javilxpez/TFG_Javi_lopez/memoria/capitulos/acronimos.tex

\chapter*{Acrónimos y símbolos}
\addcontentsline{toc}{chapter}{Acrónimos y símbolos}
\thispagestyle{plain}

\section*{Acrónimos}
\begin{longtable}{@{}L{0.18\textwidth}L{0.76\textwidth}@{}}
\toprule
\textbf{Sigla} & \textbf{Significado} \\
\midrule
\endhead
A/D, ADC & Convertidor analógico-digital (\emph{Analog-to-Digital Converter}) \\
API      & Interfaz de programación de aplicaciones \\
CDC      & Clase de dispositivo USB de comunicaciones (puerto serie virtual) \\
CRC      & Código de redundancia cíclica (\emph{Cyclic Redundancy Check}) \\
CSV      & Valores separados por comas (\emph{Comma-Separated Values}) \\
DE / RE  & Habilitación del emisor / receptor de un transceptor RS-485 \\
DI / DO  & Entrada digital / salida digital \\
EEPROM   & Memoria no volátil borrable eléctricamente \\
ESD      & Descarga electrostática (\emph{Electrostatic Discharge}) \\
FC       & Final de carrera \\
GPIO     & Entrada/salida de propósito general \\
GUI      & Interfaz gráfica de usuario \\
HTTP     & Protocolo de transferencia de hipertexto \\
I\textsuperscript{2}C & Bus serie síncrono de dos hilos (\emph{Inter-Integrated Circuit}) \\
LC       & Célula de carga (\emph{Load Cell}); LC1 y LC2 en el firmware \\
MISR     & Registro de firma de la EEPROM del ZSC31014 (\emph{Multiple-Input Signature Register}) \\
NC       & Contacto normalmente cerrado \\
ODS      & Objetivos de Desarrollo Sostenible \\
PCB      & Placa de circuito impreso (\emph{Printed Circuit Board}) \\
PIO      & E/S programable del RP2350 (\emph{Programmable I/O}) \\
POR      & Reinicio por encendido (\emph{Power-On Reset}) \\
RPM, rpm & Revoluciones por minuto \\
RS-485   & Estándar TIA/EIA-485 de transmisión diferencial multipunto \\
RTU      & Modo binario de Modbus sobre línea serie (\emph{Remote Terminal Unit}) \\
SMD      & Componente de montaje superficial \\
STO      & Desconexión segura del par (\emph{Safe Torque Off}) \\
TFG      & Trabajo Fin de Grado \\
UART     & Transmisor-receptor asíncrono universal \\
USB      & Bus serie universal \\
VRD      & Tambor de radio variable (\emph{Variable Radius Drum}) \\
WS       & WebSocket \\
\bottomrule
\end{longtable}

\section*{Símbolos principales}
\begin{longtable}{@{}L{0.17\textwidth}L{0.55\textwidth}L{0.16\textwidth}@{}}
\toprule
\textbf{Símbolo} & \textbf{Descripción} & \textbf{Unidad} \\
\midrule
\endhead
O         & Articulación de la barra & -- \\
C         & Eje de giro del tambor, en $(-x_t,\,L_2)$ & -- \\
T         & Punto de tangencia: por donde el cable abandona el tambor & -- \\
A$'$      & Punto de la barra donde tira el cable, $e_1$ sobre su eje & -- \\
P$'$      & Punto del que cuelga la masa, $e_2$ bajo el eje de la barra & -- \\
$L_2$     & Altura del eje del tambor sobre la articulación O & mm \\
$x_t$     & Eje del tambor a la izquierda de la vertical de O & mm \\
$|OC|$    & Distancia de O a C, $\sqrt{L_2^2+x_t^2}$ & mm \\
$L_3$     & De O al punto de tiro, medido sobre el eje de la barra & mm \\
$e_1$     & El cable tira $e_1$ por encima del eje de la barra & mm \\
$L_4$     & Del punto de tiro al de suspensión de la masa & mm \\
$e_2$     & La masa cuelga $e_2$ por debajo del eje de la barra & mm \\
$m$       & Masa suspendida & kg \\
$g$       & Aceleración de la gravedad & \si{\metre\per\second\squared} \\
$\theta$  & Ángulo de la barra respecto a la horizontal & ° \\
$\theta_0$& Valor de $\theta$ en B, donde arranca el ensayo & ° \\
$\theta_{\text{muerto}}$ & Punto muerto: la línea del cable pasa por O & ° \\
$\theta_{\text{libre}}$  & Reposo de la barra sin cable & ° \\
$\alpha$  & Ángulo en O entre la línea O$\to$C y la barra & ° \\
$c$       & Longitud libre de cable, de T a A$'$ & mm \\
$g_{\text{eq}}$ & Cable equivalente, $c-\operatorname{lado}\cdot r\,a_T$ & mm \\
$T$       & Tensión del cable & N \\
$\varphi$ & Giro del tambor contado desde B & rad \\
$\psi$    & Parámetro que recorre el perfil del tambor & rad \\
$r(\psi)$ & Radio del perfil del tambor & mm \\
$p$       & Brazo del cable en el eje del tambor, $p\le r$ & mm \\
$b_c$, $b_p$ & Brazos del cable y del peso respecto de O & mm \\
$r_0$, $r_1$ & Radios de la caracola al principio y al final del barrido & mm \\
$\tau$    & Par en el eje del tambor & N·m \\
$N$       & Reducción motor:tambor (vueltas de motor por vuelta de tambor) & -- \\
$p$       & Avance del eje del motor contado desde B & rev \\
$\tau_g$, $\tau_f$ & Componentes gravitatoria y de pérdidas del par medido & \ua \\
$r_{\text{ef}}$ & Radio efectivo estimado, $\propto \tau_g/T$ & \ua/N \\
\ua       & Unidades internas del accionamiento (registro 16387) & -- \\
\bottomrule
\end{longtable}
