javilxpez/TFG_Javi_lopez/memoria/capitulos/estadoarte.tex

\chapter{Estado del arte}
\label{chap:estado}

Este capítulo sitúa el trabajo frente a lo publicado sobre tambores de radio variable y mecanismos
de compensación, y frente a las plataformas con las que se ensayan.

\section{Antecedentes: variar el radio para repartir el par}

La idea de hacer variable el radio con que trabaja un cable, para que el par no siga ciegamente a la
fuerza, tiene un antecedente conocido en relojería. En los relojes de muelle el par disminuye a
medida que el muelle se desenrolla, y el \emph{fusee} lo corrige con un cono de perfil curvo y una
ranura helicoidal por la que trepa una cadena: con el muelle tenso la cadena tira del radio pequeño
y, al debilitarse, pasa al radio grande \cite{landes1983}. Lloyd \cite{lloyd1951} sitúa su origen en
el siglo XV, y Weaver \cite{weaver1980} fue quien, casi cinco siglos después, planteó por primera vez
la ecuación diferencial de su perfil.

Conviene ser preciso con el alcance de ese parecido, porque es más superficial de lo que sugiere la
analogía. El mecanismo de este trabajo \textbf{no es un fusee} ni lo imita. Un fusee es un cuerpo de
revolución cónico en el que el radio cambia \emph{axialmente}, a medida que la cadena avanza por la
hélice; aquí el tambor es una leva plana y el cable trabaja siempre en el mismo plano, con el radio
cambiando con el ángulo girado. Y, sobre todo, el problema físico es distinto: el fusee compensa una
fuerza que \emph{decae} de forma monótona, mientras que en este banco la tensión del cable no decae
---el capítulo~\ref{chap:modelo} muestra que crece---, de modo que ni el sentido de la corrección ni
la ley del perfil se trasladan. Lo único que comparten es el principio general de modular el brazo.

La familia a la que este mecanismo sí pertenece es la de los tambores de radio variable
(\emph{Variable Radius Drums}, VRD) y las poleas no circulares, formalizada en robótica.

Seriani y Gallina \cite{seriani2016} plantean la síntesis del
perfil de un tambor para que la carga siga una ley prescrita y obtienen soluciones analíticas
cerradas para varios casos. En los robots paralelos accionados por cables, Bieber \emph{et al.}
\cite{bieber2023} diseñan el perfil a partir del perfil de carga máxima del espacio de trabajo, de
modo que el par del motor no supere un valor dado para ninguna longitud de cable. Arsenault
\cite{arsenault2018} aborda el problema desde la fabricación y la cinemática del enrollado, y
establece las condiciones de \emph{convexidad} que debe cumplir el perfil para que el cable se
apoye sobre él sin despegarse ---una restricción que, como se verá, es la que acota la excentricidad
admisible en el tambor de este trabajo---. Ludovico \emph{et al.} \cite{ludovico2021} formulan la
síntesis del perfil como un problema de optimización convexa, con lo que la obtención del perfil
deja de depender de un buen punto de partida. La fabricación aditiva ha abaratado mucho estas
piezas, lo que explica el interés reciente.

\section{Compensación de gravedad con poleas no circulares}

Un segundo campo de aplicación es la compensación estática de peso. Herder \cite{herder2001} estudia
de forma sistemática los mecanismos estáticamente equilibrados, en los que la energía potencial
total se mantiene constante y el actuador sólo vence las pérdidas. Endo \emph{et al.}
\cite{endo2010} proponen una polea no circular combinada con un muelle para compensar el par
gravitatorio de un brazo, y deducen numéricamente la forma de la polea. Shen y Yano \cite{shen2022}
refinan ese cálculo teniendo en cuenta la variación de la tensión del cable a lo largo del
recorrido, y mejoran así la calidad de la compensación.

El mecanismo de este trabajo comparte el principio, con una diferencia importante: aquí no hay
muelle que almacene energía, sino un motor que aporta todo el trabajo de elevación. El tambor no
ahorra energía, sino que reparte el par.

\section{Lo que el cable impone al perfil}
\label{sec:arte-convexidad}

La literatura anterior sintetiza perfiles \emph{libres}: dada una ley de par, se obtiene la curva
$r(\varphi)$ que la produce, y se fabrica. El planteamiento es general, pero arrastra dos
restricciones que no siempre se hacen explícitas y que en este trabajo resultan decisivas.

La primera es de tolerancias. Johnston \emph{et al.} \cite{johnston2023} analizan la sensibilidad de
los mecanismos de leva enrollada a la incertidumbre en los parámetros y muestran que la ventaja
teórica de un perfil optimizado se degrada con los errores de fabricación y montaje. Gao \emph{et
al.} \cite{gao2018} resuelven el mismo problema inverso ---del par deseado al perfil--- en
mecanismos leva-muelle, y Litvin \emph{et al.} \cite{litvin2008} tratan la generación de funciones
de transmisión variables en engranajes no circulares.

La segunda es más fundamental, y es la que marca el límite de lo que se puede pedir a un tambor
accionado por cable: \textbf{un cable tenso sólo se asienta sobre un perfil convexo y de pendiente
suave}. En un tramo cóncavo, o en uno cuyo radio varíe demasiado rápido, el cable puentea el perfil
como una cuerda y el brazo que trabaja deja de ser el del perfil. Arsenault \cite{arsenault2018}
establece precisamente las condiciones de convexidad que debe cumplir un tambor de radio variable
para que el cable se apoye sobre él sin despegarse; en la práctica se traduce en mantener el ángulo
de presión $\arctan(|r'|/r)$ por debajo de unos \SI{25}{\degree}.

Esta condición es la que, en el capítulo~\ref{chap:modelo}, acaba descartando el perfil de par
exactamente constante para este banco: los perfiles que resuelven $r = \tau_0/T$ con un radio de
arranque alto exigen al cable pendientes de \SIrange{60}{80}{\degree}, que no puede seguir. La
aportación de este trabajo en ese punto no es un perfil nuevo, sino una cuantificación: sobre un
mecanismo real se muestra que, una vez impuesta la restricción del cable y comparando a igual
recorrido, la diferencia de par de pico entre todos los perfiles admisibles cae por debajo del
rozamiento del propio banco.

\section{Transmisiones por cable: el \emph{capstan drive}}
\label{sec:arte-capstan}

La reducción entre el motor y el tambor se resuelve en este trabajo con una transmisión por cable.
Su fundamento es la ecuación del cabrestante, que relaciona exponencialmente las tensiones a ambos
lados de un arrollamiento con el ángulo abrazado; Levin \cite{levin1991} la contrasta
experimentalmente, y Jung \emph{et al.} \cite{jung2008} la extienden para incluir la rigidez a
flexión de la cuerda y un rozamiento no lineal, efectos que la formulación clásica ignora y que
importan cuando el radio del cabrestante es pequeño.

Sobre ese principio, Werkmeister y Slocum \cite{werkmeister2007} caracterizan teórica y
experimentalmente la rigidez de un \emph{capstan drive}, y Baser y Konukseven \cite{baser2010} hacen
lo propio con su error de deslizamiento, las dos magnitudes que deciden si la transmisión sirve para
posicionar. En robótica, Mazumdar \emph{et al.} \cite{mazumdar2017} demuestran que una transmisión
de este tipo con fibra sintética alcanza rendimientos en torno al \SI{95}{\percent} y un ancho de
banda en par muy superior al de un reductor de engranajes, lo que la hace idónea para control de par
---que es justamente el uso que aquí se le da a la lectura del accionamiento---. Hwangbo \emph{et
al.} \cite{hwangbo2018} la llevan a robots de alta dinámica.

La configuración concreta que sigue este trabajo está tomada de un proyecto abierto de Musa
\cite{musa2024}, que documenta una reducción de \num{8.55}:1 con cuerda de Dyneema y recorrido
limitado a \SI{120}{\degree}. Conviene señalar que se trata de literatura gris, sin revisión por
pares; se cita por la utilidad de sus detalles constructivos, apoyándose para las afirmaciones de
fondo en las referencias académicas anteriores.

Las ventajas que importan aquí son la holgura nula y la transparencia de par: cualquier holgura o
rozamiento del reductor contaminaría precisamente la señal que el banco quiere medir. Las
limitaciones ---recorrido acotado y necesidad de retensado--- son asumibles en un mecanismo que
trabaja entre dos finales de carrera.

\section{Cuerda sintética frente a cable de acero}
\label{sec:arte-dyneema}

La elección del material de la cuerda no es accesoria. El criterio determinante en una transmisión
de radio pequeño es la relación entre el diámetro del tambor y el del cable, $D/d$: por debajo de
cierto valor, el cable de acero falla por fatiga de flexión en muy pocos ciclos, y Feyrer
\cite{feyrer2007} recoge el tratamiento canónico de esa vida a fatiga. Las fibras de polietileno de
ultra alto peso molecular (UHMWPE, comercialmente Dyneema) toleran radios mucho menores, lo que
permite cabrestantes pequeños y, con ellos, reducciones altas en poco espacio. McKenna \emph{et al.}
\cite{mckenna2004} es la referencia general de mecánica de cuerda de fibra, y Davies \emph{et al.}
\cite{davies2015} proponen un modelo empírico de vida bajo flexión cíclica sobre polea que permite
dimensionar $D/d$ con criterio.

El punto débil de estas fibras es la fluencia: un alargamiento permanente bajo carga mantenida que
se traduce en pérdida de tensión y, por tanto, en error de posicionamiento. Vlasblom y Bosman
\cite{vlasblom2006} modelan la vida por fluencia y muestran su fuerte dependencia del grado de fibra
y de la temperatura. De ahí que una transmisión de este tipo necesite un tensor y un retensado
periódico, y que el modelo del capítulo~\ref{chap:modelo} advierta de que la hipótesis de cable
inextensible sólo vale entre retensados.

\section{Bancos de ensayo y validación experimental}

En los trabajos citados, la validación experimental suele consistir en medir el par o la corriente
del actuador a lo largo del recorrido y compararlos con el perfil previsto. Esa comparación exige
tres medidas sincronizadas: posición del eje, fuerza en el cable y par del actuador. Los equipos
comerciales de adquisición que resuelven esto tienen un coste muy superior al del propio prototipo,
y los accionamientos industriales modernos ya publican velocidad y par por bus de campo, de modo que
buena parte de la instrumentación puede sustituirse por software.

Ésa es la oportunidad que aprovecha este TFG: construir, con componentes comerciales de bajo coste y
herramientas libres, un banco que registre las tres magnitudes con la misma base de tiempos, guarde
los datos en bruto y permita contrastar el modelo del mecanismo con la medida. Un resultado
colateral del trabajo, que se detalla en el capítulo~\ref{chap:resultados}, es que esa
instrumentación completa resulta \emph{necesaria}: la medida de fuerza por sí sola no basta para
determinar el perfil del tambor, porque la calibración desconocida de la célula admite soluciones
con el signo invertido; es el par del accionamiento el que deshace la ambigüedad.

\section{Conclusiones del estado del arte}

Los tambores de radio variable están bien estudiados como principio y existen métodos de síntesis de
su perfil, igual que están bien caracterizadas las transmisiones por cable y las fibras sintéticas
que las hacen viables. De ese panorama se desprenden las dos líneas que sigue este trabajo.

La primera es de diseño: casi toda la literatura da por supuesto que afinar el perfil merece la
pena, y lo demuestra sobre el perfil de par. Aquí se compara a igual recorrido y midiendo lo que de
verdad dimensiona el accionamiento, que es el par de pico; el capítulo~\ref{chap:modelo} muestra que
en este mecanismo la diferencia entre todos los perfiles admisibles queda por debajo del rozamiento
del banco, de modo que la elección del perfil importa mucho menos de lo esperado.

La segunda es experimental: falta una plataforma asequible que permita medir en un prototipo real
cómo se reparte el par y contrastarlo con el modelo. Para ello hay que integrar un accionamiento
industrial por Modbus, un acondicionador de célula de carga con reglas de configuración estrictas y
una cadena de adquisición con marcas de tiempo fiables, que es lo que desarrollan los capítulos
siguientes. El capítulo~\ref{chap:resultados} muestra además por qué esa instrumentación tiene que
ser completa: la fuerza sola no determina la geometría.
