javilxpez/TFG_Javi_lopez/memoria/capitulos/modelo.tex

\chapter{Modelo del mecanismo}
\label{chap:modelo}

Este capítulo desarrolla el modelo estático del mecanismo: relaciona el giro del tambor con el
ángulo de la barra, la longitud del cable y su tensión, y de ahí obtiene el par. Las mismas
ecuaciones están implementadas en \fichero{static/mecanismo.js}, de modo que el simulador, el visor
de ensayos y las figuras de esta memoria calculan exactamente lo mismo; el
anexo~\ref{anx:repo} indica cómo regenerar las cifras.

Conviene avisar de entrada de que este modelo sustituye a uno anterior, y que la diferencia no es de
refinamiento sino de física. En la primera versión el cable salía de un punto fijo D, desplazado una
distancia $dx$ de la vertical de la articulación. Ese modelo no podía representar la barra colgando
por debajo de cierto ángulo, y el ajuste lo compensaba invirtiendo el sentido de la espiral, de donde
salían unas conclusiones que la sección~\ref{sec:mod-porque} explica y descarta. El cable no sale de
un punto: sale \emph{tangente} al tambor, y el punto de salida se mueve cuando el radio cambia.

\section{Descripción del mecanismo}

La figura~\ref{fig:mecanismo} muestra el esquema. Una barra rígida articulada en O gira en un plano
vertical. El tambor va montado sobre un carril a la izquierda de O, con su eje de giro en
\begin{equation}
  C = (-x_t,\; L_2),
\end{equation}
y el cable baja desde el tambor hasta la barra. Se usan dos convenios que conviene fijar porque
atraviesan todo el capítulo:

\begin{itemize}
  \item El ángulo de la barra, $\theta$, se mide \emph{desde la horizontal}. Es lo que se configura y
        lo que se puede comprobar con un inclinómetro apoyado en la barra, sin modelo de por medio.
        Internamente se usa también $\alpha = \mathrm{inc}_C - \theta$, el ángulo en O entre la línea
        O$\to$C y la barra, que es el que entra en la ley del coseno.
  \item La barra lleva dos desfases respecto de su propio eje: el cable no tira del eje sino de un
        punto A$'$ situado $e_1$ por encima, y la pesa no cuelga del eje sino de P$'$, $e_2$ por
        debajo. Con $\hat u = (\cos\theta, \operatorname{sen}\theta)$ la dirección de la barra y
        $\hat n$ su perpendicular,
        \begin{equation}
          A' = L_3\,\hat u + e_1\,\hat n, \qquad P' = (L_3+L_4)\,\hat u - e_2\,\hat n .
        \end{equation}
\end{itemize}

\begin{figure}[H]
\centering
\begin{tikzpicture}[scale=1.55,>=Stealth]
  \coordinate (O)  at (0,0);
  \coordinate (C)  at (-0.45,3.30);
  \coordinate (Ap) at (0.856,-0.458);
  \coordinate (Pp) at (1.442,-1.471);
  \coordinate (Tg) at (0.037,3.403);
  \coordinate (Aej) at (0.728,-0.611);
  % carril y suelo
  \draw[gray!45,line width=2pt] (-0.45,-1.0) -- (-0.45,3.75);
  \fill[gray!25] (-0.22,-0.12) rectangle (0.22,0);
  % tambor
  \draw[violet,thick,fill=violet!7] (C) circle (0.50);
  \fill[violet] (C) circle (1.1pt) node[left=3pt,font=\small] {C};
  \draw[violet,dashed] (C) -- (Tg);
  \node[violet,font=\small] at (-0.03,3.17) {$r$};
  \node[violet,font=\small,right] at (0.08,3.72) {tambor};
  % barra
  \draw[line width=2.2pt] (O) -- (Pp);
  \draw[dashed,gray] (O) -- (1.35,0);
  \draw[->] (0.60,0) arc (0:-40:0.60);
  \node[font=\small] at (0.80,-0.15) {$\theta$};
  % cable
  \draw[blue!70!black,thick] (Ap) -- (Tg) node[pos=0.42,right=1pt] {$c$};
  \draw[->,thick,red!75!black] (Ap) -- ($(Ap)!0.18!(Tg)$) node[right=2pt] {$T$};
  \fill (Tg) circle (1.0pt) node[above right=-2pt,font=\small] {T};
  % puntos de la barra
  \draw[blue!70!black,thin] (Aej) -- (Ap);
  \fill[blue!70!black] (Ap) circle (1.3pt) node[above right=-2pt,font=\small] {A$'$};
  \fill[gray] (Aej) circle (0.8pt);
  \node[font=\scriptsize,gray,right=1pt] at (0.84,-0.60) {$e_1$};
  \fill[orange!80!black] (Pp) circle (1.3pt) node[below right=-1pt,font=\small] {P$'$};
  \draw[->,thick] (Pp) -- ++(0,-0.42) node[right] {$mg$};
  % cotas
  \draw[<->] (-0.95,0) -- (-0.95,3.30) node[midway,left] {$L_2$};
  \draw[dotted] (-1.0,3.30) -- (-0.50,3.30);
  \draw[<->] (-0.45,-0.75) -- (0,-0.75) node[midway,below=-1pt,font=\small] {$x_t$};
  \fill (O) circle (1.5pt) node[above left=-1pt] {O};
  \node[font=\small] at (0.40,-0.52) {$L_3$};
  \node[font=\small] at (1.32,-0.86) {$L_4$};
\end{tikzpicture}
\caption{Esquema del mecanismo. El cable sale \emph{tangente} al tambor, en el punto T, y no de un
punto fijo: al cambiar el radio, la línea del cable se desplaza.}
\label{fig:mecanismo}
\end{figure}

El modelo parte de las siguientes hipótesis:
\begin{enumerate}[label=H\arabic*.]
  \item Régimen cuasiestático: a velocidad constante se desprecian las fuerzas de inercia.
  \item Cable inextensible y sin masa, que se mantiene tenso y se asienta sobre el perfil.
  \item Se desprecia la masa de la barra frente a la masa suspendida.
  \item Las pérdidas por rozamiento no entran en el modelo estático: se tratan aparte en la
        sección~\ref{sec:mod-separacion}.
\end{enumerate}

\section{Los dos ángulos límite del mecanismo}

Antes de las ecuaciones conviene fijar dos ángulos que no son parámetros de diseño sino propiedades
de la geometría, y que acotan el recorrido útil.

El \textbf{punto muerto} es el ángulo al que la línea del cable pasa por O. Ahí el brazo del cable se
anula mientras la pesa sigue haciendo momento, de modo que la tensión se iría a infinito y el
mecanismo no puede sostener la carga. Ocurre cuando A$'$ cae sobre la tangente trazada desde O al
tambor, que forma un ángulo $\gamma = \arcsin(r/|OC|)$ con la línea O$\to$C:
\begin{equation}
  \theta_{\text{muerto}} = \mathrm{inc}_C - \operatorname{lado}\cdot\gamma - \delta - 180^\circ,
  \qquad \delta = \arctan\frac{e_1}{L_3},
  \label{eq:muerto}
\end{equation}
donde $\operatorname{lado} = +1$ si el cable baja por la derecha del tambor. Con la geometría del
banco cae en \SI{-106.4}{\degree}.

El \textbf{reposo libre} es el ángulo al que queda la barra sin cable: la pesa se sitúa justo bajo el
pivote y su brazo se anula. Como el cable sólo puede tirar, nunca empujar, es el $\theta$ mínimo al
que la barra puede quedarse:
\begin{equation}
  \theta_{\text{libre}} = -\arctan\frac{L_3+L_4}{e_2},
  \label{eq:libre}
\end{equation}
que con $L_3+L_4 = \SI{205}{\milli\metre}$ y $e_2 = \SI{20}{\milli\metre}$ da
\SI{-84.4}{\degree}. Es una cota que se mide sin modelo —inclinómetro sobre la barra con el cable
flojo— y de ella sale $e_2$, que resulta ser el parámetro más sensible del banco. Explica además las
lecturas minúsculas y erráticas de la célula al principio del ensayo: ahí el mecanismo no necesita
fuerza.

\section{Tensión del cable}
\label{sec:mod-tension}

Con $|OC| = \sqrt{L_2^2 + x_t^2}$ y $L_3' = \sqrt{L_3^2+e_1^2}$, la ley del coseno en el triángulo
O--C--A$'$ da la distancia del eje del tambor al punto de tiro:
\begin{equation}
  d^2 = |OC|^2 + L_3'^2 - 2\,|OC|\,L_3'\cos\beta, \qquad \beta = \alpha - \delta .
  \label{eq:dca}
\end{equation}
Como el radio es perpendicular a la tangente, el cable libre es el cateto del triángulo rectángulo
C--T--A$'$:
\begin{equation}
  c = \sqrt{d^2 - r^2}.
  \label{eq:cable}
\end{equation}

El equilibrio de momentos en O enfrenta el brazo del cable, $b_c$ ---la distancia de O a la recta
T--A$'$---, con el brazo del peso, que por colgar la pesa por debajo del eje tiene dos términos:
\begin{equation}
  \boxed{\;T = \frac{m\,g\,b_p}{b_c}\;}\qquad
  b_p = (L_3+L_4)\cos\theta + e_2\operatorname{sen}\theta .
  \label{eq:tension}
\end{equation}
El segundo término de $b_p$ es el que hace que el brazo del peso se anule en
$\theta_{\text{libre}}$ en lugar de en \SI{-90}{\degree}.

\subsection{El cable equivalente}
\label{sec:mod-equivalente}

Aquí está el punto más delicado del modelo. Al moverse la barra, el punto de tangencia T
\emph{migra} por la superficie del tambor, y esa migración enrolla o desenrolla cable sin que el
tambor haya girado. Dicho de otro modo: el cable que el tambor paga al girar no es la variación del
cable libre $c$. Lo que se conserva es el \emph{cable equivalente}
\begin{equation}
  g = c - \operatorname{lado}\cdot r\,a_T ,
  \label{eq:equivalente}
\end{equation}
siendo $a_T$ el ángulo del punto de tangencia sobre el tambor. La comprobación es por trabajos
virtuales: $-\mathrm{d}g/\mathrm{d}\theta$ es exactamente el brazo del cable en O, mientras que
$-\mathrm{d}c/\mathrm{d}\theta$ se queda entre un \SI{10}{\percent} y un \SI{30}{\percent} corto.
Sin este término el modelo recogía unos \SI{10}{\milli\metre} de más en cada recorrido, un error del
mismo orden que lo que se quería medir.

\subsection{Contacto exacto con el perfil}
\label{sec:mod-contacto}

Las ecuaciones anteriores suponen que el cable sale tangente a una \emph{circunferencia} de radio
$r$. En un tambor de radio variable eso es una aproximación: el perfil tiene pendiente, y la recta
tangente a la circunferencia del radio local cortaría el lóbulo que viene detrás. El cable real toca
el perfil donde es tangente \emph{al perfil}, en un punto $\psi^*$ que se obtiene de
\begin{equation}
  \big(P(\psi) - A'\big) \times \frac{\mathrm{d}P}{\mathrm{d}\psi} = 0 ,
  \label{eq:contacto}
\end{equation}
y de ahí salen las dos magnitudes que importan: el brazo del par en el tambor es la distancia del
eje a esa recta, que es \emph{menor} que $r$ donde el perfil tiene pendiente, y el cable enrollado es
la longitud de \emph{arco} del perfil, no $r$ por el ángulo. El par en el tambor y en el motor son
\begin{equation}
  \tau = T\,p(\psi^*), \qquad \tau_m = \frac{\tau}{N\,\eta},
  \label{eq:par}
\end{equation}
con $p$ ese brazo, $N$ la reducción y $\eta$ el rendimiento de la transmisión.

Con el radio variando no queda relación cerrada entre el giro del tambor y el ángulo de la barra, de
modo que la trayectoria $\theta(\varphi)$ se integra paso a paso imponiendo que el cable total
---libre más arco enrollado--- se conserve. Es lo que hace \codigo{Mec.trayectoria()}, y lo que
consultan después todas las demás funciones.

\subsection{Comprobación: balance de energía}

El modelo no se ajusta a nada; conviene por tanto comprobarlo contra una identidad física. El
trabajo que entrega el tambor a lo largo del recorrido tiene que ser la energía potencial que gana
la masa:
\begin{equation}
  \int_0^{\varphi_{\text{tot}}} \tau\,\mathrm{d}\varphi \;=\; m\,g\,\Delta h_{P'} .
  \label{eq:energia}
\end{equation}
Integrando numéricamente con la geometría del banco se obtiene \SI{3.5685}{\joule} por el primer
miembro y \SI{3.5686}{\joule} por el segundo: coinciden en la cuarta cifra. Es una comprobación
exigente, porque recorre toda la cadena ---perfil, contacto, cable equivalente y trayectoria--- y
cualquier inconsistencia en el brazo o en el cable pagado rompería la igualdad.

\section{Parámetros del mecanismo}

\begin{table}[H]
\centering
\caption{Parámetros del mecanismo \verificar{cotas tomadas del CAD y del banco; conviene
contrastarlas con una medición directa sobre el montaje}.}
\label{tab:geometria}
\begin{tabular}{@{}lll@{}}
\toprule
Parámetro & Valor & Comentario \\
\midrule
$L_2$ & \SI{330}{\milli\metre} & altura del eje del tambor sobre O \\
$x_t$ & \SI{30}{\milli\metre} & eje del tambor a la izquierda de O (es el carril) \\
$|OC|$ & \SI{331.4}{\milli\metre} & línea O$\to$C, a \SI{95.2}{\degree} \\
$L_3$ & \SI{95}{\milli\metre} & del pivote al punto de tiro, sobre el eje de la barra \\
$e_1$ & \SI{20}{\milli\metre} & el cable tira por encima del eje \\
$L_4$ & \SI{110}{\milli\metre} & resto de barra hasta la pesa \\
$e_2$ & \SI{20}{\milli\metre} & la pesa cuelga por debajo del eje \\
$m$ & \SI{2}{\kilo\gram} & masa suspendida \\
$\theta_0$ & \SI{-87}{\degree} & barra en B, medida con inclinómetro \\
$r_0 \to r_1$ & \SIrange{56}{28.18}{\milli\metre} & radios de la espiral, medidos sobre el CAD \\
Barrido & \SI{0.367}{rev} de tambor & $=\SI{1.835}{rev}$ de motor medidas \\
$N$ & 5 & reducción motor:tambor \\
\midrule
$\theta_{\text{muerto}}$ & \SI{-106.4}{\degree} & de~\eqref{eq:muerto}, no es un parámetro \\
$\theta_{\text{libre}}$ & \SI{-84.4}{\degree} & de~\eqref{eq:libre}, no es un parámetro \\
\bottomrule
\end{tabular}
\end{table}

\section{Qué hace realmente este mecanismo}
\label{sec:mod-porque}

Con el modelo cerrado se puede responder a la pregunta de diseño, y la respuesta obliga a corregir
lo que se creía al empezar.

\subsection{La tensión no baja: sube}

La intuición de partida era la del compensador clásico: al subir la barra la tensión del cable
disminuye, y el tambor tiene que ir dando radio para mantener el par. En esta geometría \emph{no es
así}. Sobre el tramo en que el cable trabaja con carga, la tensión del modelo \emph{crece} de
\num{36.7} a \SI{41.5}{\newton}, un \SI{+13}{\percent}, y pasada la horizontal sigue creciendo hasta
dispararse cerca de \SI{70}{\degree}, donde el cable se alinea con la barra. La razón es que el brazo
del peso y el brazo del cable crecen casi a la vez y se cancelan en buena medida: la barra, por sí
sola, ya está casi compensada.

De ahí se sigue lo importante: \emph{aquí hay poco que compensar}. El tambor no está corrigiendo una
tensión que se desploma, sino modulando una tensión que varía poco.

\subsection{Por qué el par de pico, y por qué a igual número de vueltas}
\label{sec:mod-criterio}

Antes de comparar perfiles hay que fijar con qué criterio, porque de eso depende todo lo demás.

\paragraph{La energía no sirve como criterio.} El trabajo de subir la masa no depende del perfil:
es $m\,g\,\Delta h$ y punto. Un tambor no ahorra energía, sólo la reparte a lo largo del giro.

\paragraph{El par de pico sí.} Un motor y su accionamiento se eligen por el par máximo que tienen
que dar, aunque sea un instante. Si el par sube un \SI{30}{\percent} a lo largo del recorrido, hace
falta un equipo un \SI{30}{\percent} mayor que el resto del tiempo va sobrado. Aplanar la curva baja
el pico hacia la media, y la relación pico/media es, por tanto, la medida directa del beneficio. Hay
además dos razones de segundo orden que apuntan en el mismo sentido: el par es corriente y las
pérdidas en el cobre van con su cuadrado, de modo que para el mismo trabajo la corriente eficaz
---y el calentamiento--- es mínima cuando la corriente es constante; y el lazo de velocidad ve una
perturbación constante en lugar de una rampa, lo que mejora el seguimiento sin tocar ganancias.

\paragraph{Y la comparación tiene que ser a igual número de vueltas.} Ésta es la condición que hace
no trivial todo el problema, y conviene plantearla como la objeción natural: \emph{si lo que se
quiere es menos par, ¿no basta con poner un cilindro más pequeño?} Un cilindro más pequeño baja el
par, sí, pero no gratis: el tambor sólo tiene dos cosas que ofrecer, par y cable por vuelta, y las
dos son el mismo radio,
\begin{equation}
  \tau = T\,r, \qquad \frac{\mathrm{d}s}{\mathrm{d}\varphi} = r .
\end{equation}
Bajar el radio baja las dos a la vez: menos par, pero también menos recorrido por vuelta, es decir
más vueltas y más tiempo de ciclo. Lo que un tambor de radio variable ofrece es precisamente
desacoplarlas: usar radio grande mientras la tensión es baja ---avanzando deprisa sin pasarse de
par--- y pasar a radio pequeño justo cuando la tensión sube. En el mejor de los casos consigue
\emph{el pico del cilindro pequeño con las vueltas del grande}. Dicho al revés: para un motor dado y
un tiempo de ciclo dado, es lo que permite levantar más carga.

Por eso la tabla siguiente escala cada perfil para que la barra llegue al mismo ángulo final en las
mismas vueltas de motor. Sin esa normalización se estarían comparando ciclos de duración distinta, y
cualquier tambor pequeño parecería mejor.

\subsection{Comparación de perfiles a igual recorrido}

La comparación tiene que hacerse a igual recorrido, o el tambor más grande parece peor sólo porque
mueve más carga por vuelta. La tabla~\ref{tab:perfiles} escala cada perfil para que la barra llegue
al mismo ángulo final en las mismas vueltas de motor.

\begin{table}[H]
\centering
\caption{Perfiles de tambor a igual recorrido (barra hasta \SI{-2.6}{\degree} en \SI{1.78}{rev} de
motor). El par de pico es lo que dimensiona el motor; el rizado, lo que mide la compensación.}
\label{tab:perfiles}
\begin{tabular}{@{}lccc@{}}
\toprule
Perfil & $r$ inicial $\to$ final & $\tau$ de pico & Rizado \\
       & (mm) & (N·m) & \\
\midrule
Cilindro & 44,6 $\to$ 44,6 & 1,84 & \SI{13.4}{\percent} \\
Espiral de la pieza, 56 $\to$ 28 mm & 48,8 $\to$ 33,3 & 1,80 & \SI{25.2}{\percent} \\
Espiral de la pieza con su meseta & 46,2 $\to$ 38,3 & 1,82 & \SI{13.6}{\percent} \\
\textbf{Espiral suave, 52 $\to$ 44 mm} & \textbf{45,7 $\to$ 41,4} & \textbf{1,75} & \textbf{\SI{5.5}{\percent}} \\
Espiral invertida & 39,8 $\to$ 58,0 & 2,39 & \SI{52.5}{\percent} \\
\bottomrule
\end{tabular}
\end{table}

Dos lecturas, y las dos van contra lo que se esperaba:

\begin{itemize}
  \item \textbf{El par de pico apenas depende del perfil.} Entre todas las opciones razonables va de
        \num{1.75} a \SI{1.84}{\newton\metre}: un \SI{5}{\percent} de diferencia. Como es el par de
        pico lo que dimensiona el motor, \emph{optimizar el perfil no ahorra motor}. Sólo la espiral
        invertida se sale, y lo hace para mal.
  \item \textbf{La pieza fabricada no es la mejor elección.} Con 56 $\to$ 28 mm compensa de más y
        deja un rizado del \SI{25}{\percent}, casi el doble que un simple cilindro
        (\SI{13.4}{\percent}). Una espiral mucho más suave, de 52 a \SI{44}{\milli\metre}, baja el
        rizado al \SI{5.5}{\percent} \emph{y} da el par de pico más bajo de la tabla.
\end{itemize}

\subsection{Por qué no se persigue una leva de par constante}

Es natural preguntarse por el perfil que haría el par exactamente constante, $r = \tau_0/T$. Se ha
implementado y se descarta, por tres razones que conviene dejar escritas:

\begin{enumerate}
  \item El beneficio es marginal. Visto lo anterior, el par de pico que se ganaría frente a una
        espiral suave está dentro del \SI{5}{\percent}, mientras que el rozamiento seco medido es del
        \SI{18}{\percent} del par (sección~\ref{sec:res-friccion}). Se optimizaría muy por debajo del
        ruido del sistema.
  \item No hay solución en el arranque. Con el cable flojo la tensión tiende a cero y el radio que
        pide el par constante tiende a infinito; hay que acotarlo a un radio máximo, y ese tope
        acaba fijando el perfil tanto como el criterio de par constante.
  \item \textbf{El cable no sigue cualquier perfil.} Un cable tenso sólo se asienta sobre un perfil
        \emph{convexo} y de pendiente suave; en un tramo cóncavo lo puentea como una cuerda, y
        entonces ni el radio ni el par son los que dice el modelo. El criterio práctico es mantener
        el ángulo de presión $\arctan(|r'|/r)$ por debajo de unos \SI{25}{\degree}. Los perfiles de
        par constante con radio de arranque alto lo violan de largo, con ángulos de
        \SIrange{60}{80}{\degree}.
\end{enumerate}

Esta última condición es la restricción física de fondo, y vale para cualquier tambor de radio
variable accionado por cable: no se puede pedir al perfil una variación de radio más rápida de lo
que el cable puede seguir.

\section{Método experimental: separación del par y brazo efectivo}
\label{sec:mod-separacion}

El accionamiento entrega el par en unidades internas de escala desconocida, y el par medido incluye
las pérdidas por rozamiento. Para comparar con el modelo sin depender de esa escala se recorre el
mismo punto en los dos sentidos, a la misma velocidad. Las pérdidas se oponen siempre al movimiento,
mientras que el par gravitatorio conserva el signo:
\begin{equation}
  \tau_g = \frac{|\tau_{\uparrow}| + |\tau_{\downarrow}|}{2}, \qquad
  \tau_f = \frac{|\tau_{\uparrow}| - |\tau_{\downarrow}|}{2}.
  \label{eq:separacion}
\end{equation}
El mismo promedio aplicado a la señal de la célula elimina en primera aproximación el retardo de su
filtro, que desplaza en sentidos opuestos las curvas de ida y de vuelta.

Con $\tau_g$ limpio de pérdidas, \eqref{eq:par} permite estimar el \emph{brazo efectivo}
\begin{equation}
  p_{\text{ef}}(\varphi) \;\propto\; \frac{\tau_g(\varphi)}{T(\varphi)},
  \label{eq:brazo-efectivo}
\end{equation}
donde $T$ se toma del modelo, que no necesita la célula de carga: sólo la geometría y la masa. En un
tambor cilíndrico $p_{\text{ef}}$ sería constante; su forma es, por tanto, una medida directa del
perfil que el cable está recorriendo.

\subsection{Por qué no basta con medir la fuerza}
\label{sec:mod-ambiguedad}

La célula no está calibrada con masas patrón, de modo que la comparación con el modelo se hace
ajustando una escala. El coeficiente de determinación de ese ajuste es el cuadrado del coeficiente de
correlación, $R^2 = \rho^2$, y \emph{no cambia si se invierte el signo de la escala}: una geometría
que prediga una tensión creciente y otra que la prediga decreciente pueden puntuar igual. La medida
de fuerza, por sí sola, no puede decidir en qué sentido trabaja el mecanismo.

El par del accionamiento sí puede, porque su signo y su escala son propios del equipo y no dependen
de ninguna calibración pendiente. Por eso el criterio del capítulo~\ref{chap:resultados} es comparar
$\tau_g$ con el par del modelo ajustando \emph{una sola} constante positiva $k$ ---el paso de
unidades internas a newton-metro--- y medir
\begin{equation}
  R^2 = 1 - \frac{\sum_i \big(\tau_{g,i} - k\,\tau_i^{\text{mod}}\big)^2}
                 {\sum_i \big(\tau_{g,i} - \bar\tau_g\big)^2}, \qquad k>0 .
  \label{eq:r2-par}
\end{equation}
Usar en su lugar $\rho^2$ premia a un modelo que prediga la tendencia contraria a la medida, y la
sección~\ref{sec:res-contraste} muestra que la diferencia no es académica.

\section{Limitaciones del modelo}

\begin{itemize}
  \item Las cotas de la tabla~\ref{tab:geometria} proceden del CAD y de medidas sobre el banco, no de
        una metrología cuidada. $e_2$ es el parámetro más sensible y el que conviene medir mejor, a
        través de $\theta_{\text{libre}}$.
  \item Se supone que el cable trabaja en una sola capa y que se asienta sobre el perfil. Con varias
        capas el brazo crece con el espesor acumulado, y en tramos de pendiente fuerte el cable
        puentea el perfil.
  \item Se desprecian la elasticidad del cable y la masa de la barra. Con cuerda sintética la
        hipótesis de cable inextensible sólo vale a corto plazo, entre retensados.
  \item El rendimiento y las pérdidas se suponen iguales en los dos sentidos, en valor absoluto, para
        poder aplicar~\eqref{eq:separacion}.
  \item El modelo es estático: no describe el tramo inicial con el cable destensado ni los
        transitorios de arranque e inversión.
\end{itemize}
