javilxpez/TFG_Javi_lopez/memoria/capitulos/agradecimientos.tex

\chapter{Agradecimientos}

\completar{Agradecimientos: tutoría, departamento o laboratorio que ha prestado el material,
compañeros y familia.}
