javilxpez/TFG_Javi_lopez/memoria/capitulos/evaluacion.tex

\cleardoublepage

\begin{flushleft} \large
\textbf{Título:} Banco de ensayos para una caracola de radio variable: control del
servoaccionamiento, adquisición de fuerza y validación del modelo \\
\textbf{Autor:} \autortfg\\
\textbf{Tutor:} \completar{nombre del tutor} \\
\textbf{Cotutor:} \completar{nombre del cotutor}\\ [1 cm]

\end{flushleft}

\begin{center} \LARGE
EL TRIBUNAL \\ [1 cm]
\end{center}

\begin{flushleft} \LARGE
Presidente: \\ [1 cm]
Vocal: \\ [1 cm]
Secretario: \\ [1.5 cm]
\end{flushleft}

\large
Realizado el acto de defensa y lectura del Trabajo Fin de Grado el día ....... de
....................   de ... en .........., en la Escuela Técnica Superior de Ingeniería y
Diseño Industrial de la Universidad Politécnica de Madrid, acuerda otorgarle la CALIFICACIÓN
de: \\ [2 cm]

\begin{center}
 \large VOCAL \\ [2.2 cm]
\end{center}

\begin{multicols}{2}
\begin{flushleft}
\large SECRETARIO
\end{flushleft}

\begin{flushleft}
\large PRESIDENTE
\end{flushleft}
\end{multicols}

\normalsize
