javilxpez/TFG_Javi_lopez/memoria/capitulos/firmas.tex

\thispagestyle{empty}
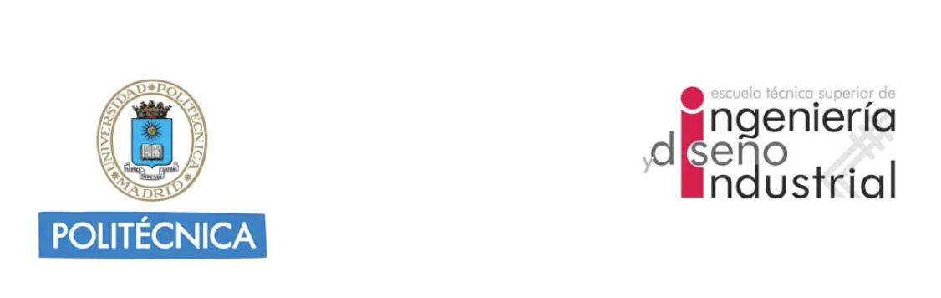
[picture p4: memoria/figuras/cabecera.png]
  \\[0.5 cm]

\LARGE UNIVERSIDAD POLITÉCNICA DE MADRID \\ [1 cm]

\LARGE ESCUELA TÉCNICA SUPERIOR DE INGENIERÍA Y DISEÑO INDUSTRIAL \\ [1 cm]

\LARGE Grado en Ingeniería Electrónica y Automática Industrial\\ [1 cm]

\LARGE \textbf{TRABAJO FIN DE GRADO}\\[1 cm]

\huge \textsc{Banco de ensayos para una caracola de radio variable}\\[3 cm]

\Large Firma del autor: \autortfg \\[3 cm]

\begin{multicols}{2}
\begin{flushleft}
\Large \emph{Firma del cotutor (si lo hay)}
\end{flushleft}

\begin{flushleft}
\Large \emph{Firma del tutor}
\end{flushleft}
\end{multicols}

\vfill
{\large Madrid, \completar{mes}, 2026}

\end{center}
\end{titlepage}
\normalsize
