javilxpez/TFG_Javi_lopez/memoria/capitulos/portada.tex

\begin{titlepage}
\begin{center}

   \\[0.5 cm]

\LARGE UNIVERSIDAD POLITÉCNICA DE MADRID \\ [1 cm]

\LARGE ESCUELA TÉCNICA SUPERIOR DE INGENIERÍA Y DISEÑO INDUSTRIAL \\ [1 cm]

\LARGE Grado en Ingeniería Electrónica y Automática Industrial\\ [1 cm]

\LARGE \textbf{TRABAJO FIN DE GRADO}\\[1 cm]

\huge \textsc{Banco de ensayos para una caracola de radio variable: control del
servoaccionamiento, adquisición de fuerza y validación del modelo}\\[1 cm]

\LARGE \autortfg \\[2 cm]

\begin{multicols}{2}
\begin{flushleft} \Large
\emph{Cotutor (si lo hay):} \completar{nombre y apellidos} \\
\emph{Departamento:} \completar{departamento}
\end{flushleft}

\begin{flushleft} \Large
\emph{Tutor:} \completar{nombre y apellidos}\\
\emph{Departamento:} \completar{departamento}
\end{flushleft}

\end{multicols}

\vfill

{\large Madrid, \completar{mes}, 2026}

\cleardoublepage
