javilxpez/TFG_Javi_lopez/LATEX plantilla TFG ETSIDI v3/plantilla TFG ETSIDI v3 En desarrollo/capitulos/portada.tex

\begin{titlepage}
\begin{center}

%forma de introducir imágenes. el \\[0.5 cm] de final de línea introduce un salto de ese tamaño.
%width=1\textwidth indica el tamaño de la imágen (valores entre 0-1). 
   \\[0.5 cm]

\LARGE UNIVERSIDAD POLITÉCNICA DE MADRID \\ [1 cm]

\LARGE ESCUELA TÉCNICA SUPERIOR DE INGENIERÍA Y DISEÑO INDUSTRIAL \\ [1 cm]

\LARGE Grado en Ingeniería Electrónica y Automática Industrial\\ [1 cm]

\LARGE \textbf{TRABAJO FIN DE GRADO}\\[1 cm]

\Huge \textsc{Título del trabajo}\\[1 cm]

\LARGE Autor \\[2 cm]

%flushleft alinea a la izquierda el texto

\begin{multicols}{2} 
\begin{flushleft} \Large
\emph{Cotutor (si lo hay):} nombre y apellidos \\
\emph{Departamento:} departamento
\end{flushleft}

\begin{flushleft} \Large
\emph{Tutor:} nombre y apellidos\\
\emph{Departamento:} departamento
\end{flushleft}

\end{multicols} 

%rellena de blanco el resto de la página para escribir abajo del todo
\vfill

% Bottom of the page
{\large Ciudad, Mes, Año}

%SE ponen al final firmas.tex
%\end{center}
%\end{titlepage}

\cleardoublepage
