javilxpez/TFG_Javi_lopez/memoria/_v1/capitulos/00_acronimos.tex

\chapter*{Acrónimos y símbolos}
\addcontentsline{toc}{chapter}{Acrónimos y símbolos}
\thispagestyle{plain}

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

\section*{Símbolos principales}
\begin{longtable}{@{}L{0.17\textwidth}L{0.55\textwidth}L{0.16\textwidth}@{}}
\toprule
\textbf{Símbolo} & \textbf{Descripción} & \textbf{Unidad} \\
\midrule
\endhead
$L_2$     & Altura del punto de salida del cable sobre la articulación O & mm \\
$L_3$     & Distancia de O al punto de anclaje del cable en la barra & mm \\
$L_4$     & Distancia del anclaje del cable al punto de suspensión de la masa & mm \\
$m$       & Masa suspendida & kg \\
$g$       & Aceleración de la gravedad & \si{\metre\per\second\squared} \\
$\theta$  & Ángulo de la barra respecto a la horizontal (positivo hacia arriba) & ° \\
$c$       & Longitud libre de cable entre la salida y el anclaje & mm \\
$T$       & Tensión del cable & N \\
$K$       & Constante de proporcionalidad $T = Kc$ & N/mm \\
$\varphi$ & Giro del tambor (caracola) medido desde el origen del recorrido & rad \\
$r(\varphi)$ & Radio instantáneo de enrollamiento del tambor & mm \\
$s(\varphi)$ & Cable pagado por el tambor, $s=\int r\,\mathrm{d}\varphi$ & mm \\
$\tau$    & Par en el eje del tambor & N·m \\
$N$       & Reducción motor:tambor (vueltas de motor por vuelta de tambor) & -- \\
$\tau_g$, $\tau_f$ & Componentes gravitatoria y de pérdidas del par medido & \ua \\
$p$       & Posición integrada del eje del motor & rev \\
\ua       & Unidades internas del accionamiento (registro 16387) & -- \\
\bottomrule
\end{longtable}
