javilxpez/TFG_Javi_lopez/memoria/_v1/capitulos/06_firmware.tex

\chapter{Firmware del microcontrolador}
\label{chap:firmware}

\section{Entorno y organización}

El firmware se ha desarrollado en C++ con el entorno Arduino y el núcleo Arduino-Pico
\cite{arduinopico}, que da acceso a los periféricos del RP2350 y a su SDK. Usa las bibliotecas
\codigo{Wire} (I\textsuperscript{2}C), \codigo{SerialPIO} (UART implementada con PIO) y ModbusMaster
\cite{modbusmaster}. El código final está en \fichero{firmware\_posicion\_v2/}: un fichero principal
de unas 1500 líneas y la cabecera \fichero{i2c\_bus.h} con el árbitro del bus I\textsuperscript{2}C.

El diseño sigue un principio que se repite en todo el código: \emph{cada bus tiene un único dueño y
un único punto del lazo donde se usa}. Sólo dos funciones tocan el bus RS-485
(\codigo{servoReadState} y \codigo{servoAction}) y sólo dos tocan el bus I\textsuperscript{2}C durante
el funcionamiento (\codigo{i2cUpdate} y \codigo{lcRequestService}). El intérprete de órdenes
(\codigo{processCommand}) nunca accede a un bus: se limita a modificar variables de estado, que el
lazo lee en el punto que corresponde. Así, la llegada de una orden no puede interrumpir una
transacción a medias.

El estado está en dos estructuras:
\begin{itemize}
  \item \codigo{ControlState ctrl}: estado de la aplicación (modo, errores, parámetros, célula de
        carga, posición, \emph{homing} y ciclo).
  \item \codigo{Servo sv}: contexto del enlace con el accionamiento (fase, dirección, conexión,
        contadores de fallos, consigna pendiente y últimas lecturas).
\end{itemize}

\section{Lazo principal}
\label{sec:fw-lazo}

El núcleo 0 ejecuta un lazo con periodo mínimo de \SI{50}{\milli\second} (\codigo{LOOP\_MS}). Cada vuelta
tiene cinco fases (listado~\ref{lst:loop}).

\begin{lstlisting}[language=C++,caption={Estructura del lazo principal (simplificada).},label={lst:loop}]
void loop(){
  unsigned long now = millis();  uint32_t t0us = micros();

  // == LECTURA ==
  servoReadState();      // RS-485: velocidad y par (2 transacciones)
  lcRequestService();    // consulta/programación de la célula si se ha pedido
  i2cUpdate();           // I2C: una lectura de la célula
  positionUpdate();      // integra rpm -> posición (sin buses)

  // == LÓGICA == (sin acceso a buses)
  checkCommands();       // órdenes USB -> variables de estado
  if (ctrl.lcProgBusy)      { sv.speedCmd = 0; ctrl.cycPhase = CYC_IDLE; }
  else if (homing en curso)   homingUpdate();
  else                      { homingUpdate(); cycleUpdate(); }
  // protecciones: límite de fuerza y finales de carrera anulan la consigna
  // derivación del estado de la aplicación para la telemetría

  // == ACTUACIÓN ==
  servoAction();         // RS-485: máquina de estados del servo y escritura de consigna

  // == REGISTRO ==
  recordSample(now, micros() - t0us);
  if (sampleCount >= MAX_SAMPLES || now - ctrl.lastTelemetryTime >= 200)
    telemetryFlush();    // + tramas de homing y de ciclo si están activos

  // == RITMO ==
  unsigned long dt = millis() - now;
  if (dt < LOOP_MS) delay(LOOP_MS - dt);
}
\end{lstlisting}

Este orden tiene consecuencias deliberadas:
\begin{itemize}
  \item Las protecciones se evalúan \emph{después} de la lógica y \emph{antes} de la escritura.
        Ninguna consigna generada por el \emph{homing}, el ciclo o una orden manual puede llegar al
        accionamiento sin pasar por ellas.
  \item Una orden recibida se aplica en la misma vuelta, porque la escritura de la consigna es
        posterior a la lectura de órdenes.
  \item El tiempo de trabajo (\codigo{work\_us}) se mide antes del retardo de ritmo y viaja con cada
        muestra. Es la base de la caracterización temporal de la sección~\ref{sec:res-temporizacion}.
  \item El retardo final hace que el periodo no dependa de la duración del trabajo mientras ésta no
        supere \SI{50}{\milli\second}.
\end{itemize}

El núcleo 1 no se usa (\codigo{loop1()} sólo espera). La evolución desde la versión de doble núcleo
se explica en la sección~\ref{sec:prob-uart}.

\section{Máquina de estados del servo}

La figura~\ref{fig:fsm-servo} muestra la máquina de estados del enlace con el accionamiento, que
ejecuta \codigo{servoAction}.

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

En \codigo{SV\_CONFIGURING} se ejecuta la secuencia de configuración de la
sección~\ref{chap:comunicaciones}. En \codigo{SV\_RUNNING} cada vuelta escribe la consigna: un fallo
marca el servo como desconectado y pone a cero las lecturas, pero no provoca un nuevo escaneo del
bus, que es bloqueante y lento (hasta un segundo por dirección vacía). El escaneo sólo se hace bajo
demanda con la orden SCAN. El estado que se publica en la telemetría se deriva del de esta máquina y
de la consigna (STOPPED, MOVING\_A o MOVING\_B). El \emph{homing} y la programación de la célula
tienen prioridad sobre él.

\section{Lectura de la célula de carga}

El ZSC31014 trabaja en modo de conversión continua: convierte a su propio ritmo, fijado por la
palabra ZMDI\_Config1, de \num{0.5} a \SI{125}{\milli\second} según el reloj y la tasa elegidos
\cite{zsc31014}, y guarda el último resultado. Una lectura no dispara una conversión; devuelve el
último dato con dos bits de estado que indican si es nuevo o si ya se había leído.

Por ello, \codigo{loadCellUpdate} hace \emph{una sola lectura de dos bytes por vuelta}:
\begin{enumerate}
  \item Pide el bus al árbitro. Si está ocupado, pierde el turno y lo intenta en la vuelta siguiente.
  \item Lee 14 bits de dato y 2 de estado. Si el estado es ``dato válido'', lo introduce en una media
        móvil de 8 posiciones y calcula la lectura tarada \codigo{baseRead = media $-$ zeroOffset}.
  \item Si pasan más de \SI{150}{\milli\second} sin un dato válido, marca la célula como no válida. El
        límite de fuerza deja entonces de actuar, en lugar de hacerlo con un dato viejo.
\end{enumerate}

\subsection{Árbitro del bus I\textsuperscript{2}C}

La cabecera \fichero{i2c\_bus.h} implementa un árbitro mínimo: una variable con el dueño actual
(\codigo{I2C\_FREE}, \codigo{I2C\_LC1}, \codigo{I2C\_LC2} o \codigo{I2C\_CFG}) y dos funciones,
\codigo{i2cAcquire} e \codigo{i2cRelease}. La reserva se deniega si el bus tiene otro dueño o si se
pide desde el núcleo 1, y cada denegación se cuenta para el diagnóstico. El árbitro nació al
compartir el bus entre el ZSC31014 y el NAU7802 (sección~\ref{sec:prob-nau}), y se conserva para
reservar el bus en exclusiva durante la programación de la EEPROM. Nadie espera con el bus ocupado,
así que el árbitro no puede bloquear el lazo.

\section{Posición integrada}
\label{sec:fw-posicion}

La posición del eje del motor se obtiene integrando la velocidad que devuelve el accionamiento:
\begin{equation}
  p_k = p_{k-1} + \frac{n_k\,\Delta t_k}{60000}, \qquad [p]=\text{rev},\ [n]=\text{rpm},\ [\Delta t]=\text{ms}.
\end{equation}
Es una integración rectangular con la última velocidad leída y el intervalo real medido con
\codigo{millis()}. Hay que tener en cuenta tres aspectos:
\begin{itemize}
  \item \textbf{Rebase tras un hueco.} Si el lazo se detiene, por ejemplo durante la programación de la
        célula, la siguiente vuelta vería un $\Delta t$ de casi un segundo y lo multiplicaría por la
        última velocidad, inventando un desplazamiento que no ha ocurrido. Por eso se anula la base de
        tiempo (\codigo{lastPosTime = 0}) tras INIT, al iniciar el \emph{homing} y tras cualquier
        operación bloqueante.
  \item \textbf{Resolución.} El registro de velocidad tiene resolución de \SI{1}{rpm}. Si el
        accionamiento redondea, el error es de media nula; si trunca, a \SI{30}{rpm} introduciría un
        sesgo de hasta el \SI{3}{\percent}. La dispersión observada en la posición del final B
        (\SI{13}{mrev} en 1,75 rev) indica que el sesgo real es menor.
  \item \textbf{Acotación.} La deriva no se acumula entre ensayos, porque el \emph{homing} fija el
        origen en un final de carrera y cada ciclo termina con referencia a él.
\end{itemize}

\section{\emph{Homing}}

La rutina de \emph{homing} (figura~\ref{fig:homing}) establece un origen repetible y mide el recorrido
disponible:
\begin{enumerate}
  \item \textbf{Buscar A}: avanza hacia A a la velocidad de \emph{homing} hasta que se activa el final
        A, y fija ahí $p=0$.
  \item \textbf{Buscar B}: avanza hacia B hasta el final B y guarda el recorrido $p_B$.
  \item \textbf{Ir al origen}: se mueve hasta el desplazamiento configurado, acotado a $[0, p_B]$, con
        tolerancia de $\pm\SI{0.02}{rev}$. También da la llegada por buena si toca el final de carrera
        en el sentido de la marcha.
  \item Fija ese punto como nuevo origen ($p=0$) y sigue informando del resultado durante
        \SI{1.5}{\second} para que la interfaz lo muestre.
\end{enumerate}
Cualquier tramo que dure más de \SI{30}{\second}, o la pérdida del servo, aborta con fallo. Durante el
\emph{homing} se ignoran las órdenes de movimiento manual.

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

\section{Ciclo automático A$\leftrightarrow$B}

El ciclo lleva el eje del origen (A, $p=0$) al punto B y vuelve, tantas veces como se pida (0 = sin fin):
\begin{itemize}
  \item \textbf{Hacia B}: consigna $+v$ hasta que se activa el final B o, si B es una posición, hasta
        $p \ge p_B - 0{,}02$. El final B actúa siempre como tope de respaldo.
  \item \textbf{Hacia A}: consigna $-v$ hasta $p \le 0{,}02$ o hasta que se activa el final A. Al llegar
        se incrementa el contador y se decide si se termina o se empieza otra repetición.
\end{itemize}
El ciclo no hace un control fino de posición: manda velocidad y observa la posición integrada, igual
que el \emph{homing}. Sólo se acepta con el servo habilitado, sin \emph{homing} en curso y sin
programación de la célula. Los temporizadores y la pérdida del servo lo abortan, y los finales de
carrera y el límite de fuerza siguen actuando en el lazo. La prioridad es: programación de la célula
$>$ \emph{homing} $>$ ciclo $>$ movimiento manual.

\section{Configuración del acondicionador de la célula}

La consulta y la programación de la EEPROM del ZSC31014 son las operaciones más delicadas del
firmware. Por las restricciones que se analizan en la sección~\ref{sec:prob-zsc}, obligan a reiniciar
el chip y dejan la célula sin medida durante cientos de milisegundos. Se ejecutan así:

\begin{enumerate}
  \item \codigo{processCommand} sólo \emph{anota} la petición y un plazo de \SI{1}{\second}.
  \item En su punto fijo del lazo, \codigo{lcRequestService} comprueba que el eje está en reposo:
        estado IDLE o STOPPED, consigna nula y sin \emph{homing}. Si no lo está, responde
        ``rechazado''.
  \item Reserva el bus en exclusiva (\codigo{I2C\_CFG}). Si no lo consigue antes del plazo, responde
        ``bus ocupado''.
  \item Pone la consigna a cero, pasa al estado PROGRAMMING y envía la telemetría pendiente para que la
        interfaz vea el silencio que viene.
  \item Ejecuta la consulta o la programación (siguiente apartado), devuelve el bus a
        \SI{400}{\kilo\hertz}, libera el árbitro, reinicializa la célula, anula la base de la
        integración de posición y responde con el paquete \codigo{0x04}.
\end{enumerate}

\subsection{Escritura verificada}

\codigo{loadCellProgram} aplica dos reglas de la hoja de datos \cite{zsc31014}: la palabra ZMDI\_Config1
sólo se carga tras un ciclo de alimentación, y la firma MISR de la EEPROM (palabra \codigo{0x12}) se
regenera al salir del modo comando con Start\_NOM si hubo escrituras. La función hace dos pasadas:

\begin{enumerate}
  \item \textbf{Primera pasada}: entra en modo comando, lee B\_Config (\codigo{0x0F}) y ZMDI\_Config1
        (\codigo{0x01}) y calcula las palabras deseadas. Si coinciden con las actuales, termina sin
        escribir, porque la EEPROM admite 100.000 ciclos de escritura. Si no, escribe las palabras que
        cambian, espera \SI{20}{\milli\second} por escritura (típico \SI{15}{\milli\second}, peor caso
        \SI{17.3}{\milli\second}), envía Start\_NOM y espera \SI{150}{\milli\second} antes de cortar la
        alimentación (típico \SI{15}{\milli\second}).
  \item \textbf{Segunda pasada}: desde un reinicio limpio, vuelve a leer ambas palabras. Si coinciden
        con lo pedido, el resultado es ``grabado y verificado''; si no, ``fallo''.
\end{enumerate}

Las palabras deseadas se construyen a partir de las actuales, protegiendo los bits que la interfaz no
debe tocar:
\begin{itemize}
  \item B\_Config: se conservan los bits reservados [15:13]; se aplican anulación, multiplexor,
        B-sink, integración larga, polaridad, ganancia [6:4] y cero del A/D [3:0].
  \item ZMDI\_Config1: se conservan [15:9] (signos de las correcciones de segundo orden y de
        temperatura, calibrados en fábrica); se aplican tasa [7:6], modo de bajo consumo [5] y reloj
        [3]; se fuerzan el interfaz I\textsuperscript{2}C (bit 4 = 0) y el campo reservado [2:0] = 001.
\end{itemize}

\subsection{Mantenimiento del reinicio para medida}

La orden LC\_HOLD deja la célula sin alimentación durante \SI{8}{\second}, con las líneas del bus en
el estado elegido, para medir con un polímetro la tensión de la placa Click. A diferencia de la
programación, esta espera \emph{no} bloquea: el lazo sigue girando, leyendo el servo, vigilando los
finales de carrera y enviando telemetría, y en cada vuelta sólo comprueba si ha vencido el plazo.
Mientras dura, se fuerza la consigna a cero en cada vuelta: alguien tiene las manos dentro de la
máquina, y una orden de movimiento que llegue por USB no debe poder arrancar el eje.

\section{Evolución del firmware}

\begin{longtable}{@{}L{0.27\textwidth}L{0.12\textwidth}L{0.49\textwidth}@{}}
\caption{Versiones del firmware conservadas en el repositorio.}\label{tab:versiones-fw}\\
\toprule
Versión & Placa & Características \\
\midrule
\endfirsthead
\toprule
Versión & Placa & Características \\
\midrule
\endhead
\fichero{old/speedtorque\_mode} & XIAO ESP32-S3 & Escaneo Modbus y selección de modo par o velocidad. \\
\fichero{firmware} & XIAO ESP32-S3 & Protocolo binario v2, parámetros del accionamiento (rigidez, límites de par, resistencia de frenado) y regulador de fuerza en modo par con zona muerta, umbral y ganancia sobre la célula filtrada (media móvil de 12). \\
\fichero{firmwarerasp} & Pico 2 & Migración con SerialPIO. Doble núcleo: el núcleo 1 escribe la consigna y lee la supervisión Modbus en bucle, comunicado con el núcleo 0 por variables \codigo{volatile} y un protocolo de relevo (\codigo{active}/\codigo{busy}). \\
\fichero{firmware\_posicion} & Pico 2 & Modo velocidad A$\rightarrow$B sin lazo de fuerza, integración de posición, telemetría por lotes y diseño de dueño único en el núcleo 0. \\
\fichero{firmware\_posicion\_v2} & Pico 2 & Versión final: \emph{homing}, ciclos, finales de carrera, programación verificada de la EEPROM de la célula, árbitro I\textsuperscript{2}C, tiempo de trabajo en la telemetría y respuestas de diagnóstico. \\
\bottomrule
\end{longtable}
