javilxpez/TFG_Javi_lopez/memoria/_v1/capitulos/bibliografia.tex

\begin{thebibliography}{99}
\small

% ── Mecanismos de radio variable y compensación ─────────────────────────
\bibitem{landes1983}
D.~S. Landes, \emph{Revolution in Time: Clocks and the Making of the Modern World}.
Cambridge, MA: Harvard University Press, 1983.

\bibitem{herder2001}
J.~L. Herder, \emph{Energy-free systems: theory, conception and design of statically balanced
spring mechanisms}, Tesis doctoral, Delft University of Technology, 2001.

\bibitem{seriani2016}
S.~Seriani y P.~Gallina, ``Variable radius drum mechanisms,''
\emph{Journal of Mechanisms and Robotics}, vol.~8, n.º~2, art.~021016, 2016.

\bibitem{bieber2023}
J.~Bieber, D.~Bernstein y M.~Beitelschmidt, ``Variable radius drum design for cable-driven
parallel robots based on maximum load profile,'' en \emph{Cable-Driven Parallel Robots
(CableCon 2023)}, Mechanisms and Machine Science, vol.~132. Cham: Springer, 2023.
doi: 10.1007/978-3-031-32322-5\_22.

\bibitem{shen2022}
T.~Shen y K.~Yano, ``An innovative spiral pulley that optimizes cable tension variation for
superior balancing performance,'' \emph{Journal of Robotics and Mechatronics}, vol.~34, n.º~3,
pp.~599--606, 2022. doi: 10.20965/jrm.2022.p0599.

\bibitem{endo2010}
G.~Endo, H.~Yamada, A.~Yajima, M.~Ogata y S.~Hirose, ``A passive weight compensation mechanism
with a non-circular pulley and a spring,'' en \emph{Proc. IEEE International Conference on
Robotics and Automation (ICRA)}, 2010.

% ── Accionamientos y medida ─────────────────────────────────────────────
\bibitem{kenjo1994}
T.~Kenjo y A.~Sugawara, \emph{Stepping Motors and Their Microprocessor Controls}, 2.ª ed.
Oxford: Oxford University Press, 1994.

\bibitem{pallas2001}
R.~Pallàs-Areny y J.~G. Webster, \emph{Sensors and Signal Conditioning}, 2.ª ed.
Nueva York: Wiley, 2001.

\bibitem{hoffmann2012}
K.~Hoffmann, \emph{An Introduction to Stress Analysis and Transducer Design using Strain Gauges}.
Darmstadt: HBM, 2012.

% ── Normas y especificaciones ───────────────────────────────────────────
\bibitem{modbusapp}
Modbus Organization, \emph{MODBUS Application Protocol Specification V1.1b3}, 2012.

\bibitem{modbusserial}
Modbus Organization, \emph{MODBUS over Serial Line: Specification and Implementation Guide
V1.02}, 2006.

\bibitem{tia485}
Telecommunications Industry Association, \emph{TIA/EIA-485-A: Electrical Characteristics of
Generators and Receivers for Use in Balanced Digital Multipoint Systems}, 1998.

\bibitem{i2cspec}
NXP Semiconductors, \emph{UM10204: I\textsuperscript{2}C-bus specification and user manual},
rev.~7.0, 2021.

\bibitem{mikrobus}
MikroElektronika, \emph{mikroBUS Standard Specification}, v2.00.

\bibitem{rfc6455}
I.~Fette y A.~Melnikov, \emph{The WebSocket Protocol}, RFC~6455, IETF, 2011.

\bibitem{iso13849}
ISO, \emph{ISO 13849-1: Safety of machinery --- Safety-related parts of control systems ---
Part~1: General principles for design}, 2023.

\bibitem{iec61800}
IEC, \emph{IEC 61800-5-2: Adjustable speed electrical power drive systems --- Part 5-2: Safety
requirements --- Functional}, 2016.

\bibitem{rd1125}
Real Decreto 1125/2003, de 5 de septiembre, por el que se establece el sistema europeo de
créditos y el sistema de calificaciones en las titulaciones universitarias. BOE n.º~224, 2003.

\bibitem{agenda2030}
Naciones Unidas, \emph{Transformar nuestro mundo: la Agenda 2030 para el Desarrollo
Sostenible}, Resolución A/RES/70/1, 2015.

% ── Hojas de datos ──────────────────────────────────────────────────────
\bibitem{rp2350}
Raspberry Pi Ltd, \emph{RP2350 Datasheet} y \emph{Raspberry Pi Pico 2 product brief}.
Disponible en: \url{https://www.raspberrypi.com/products/raspberry-pi-pico-2/}.

\bibitem{zsc31014}
Renesas Electronics, \emph{ZSC31014 RBicLite Digital Output Sensor Signal Conditioner ---
Datasheet}. Disponible en: \url{https://www.renesas.com/en/products/zsc31014}.

\bibitem{nau7802}
Nuvoton Technology, \emph{NAU7802: 24-bit dual-channel ADC for bridge sensors --- Datasheet}.

\bibitem{thvd1400}
Texas Instruments, \emph{THVD1400: 3.3-V to 5-V RS-485 transceiver with IEC ESD protection ---
Datasheet}. Disponible en: \url{https://www.ti.com/product/THVD1400}.

\bibitem{tps4h000}
Texas Instruments, \emph{TPS4H000-Q1: 40-V, 1000-m$\Omega$ 4-channel smart high-side switch ---
Datasheet}. Disponible en: \url{https://www.ti.com/product/TPS4H000-Q1}.

\bibitem{mcp629x}
Microchip Technology, \emph{MCP6291/1R/2/3/4/5: 1.0\,mA, 10\,MHz rail-to-rail op amps ---
Datasheet}.

\bibitem{bzx384}
Nexperia, \emph{BZX384 series: Voltage regulator diodes --- Datasheet}.

\bibitem{mikroelc2}
MikroElektronika, \emph{Load Cell 2 Click --- Documentación del producto}.
Disponible en: \url{https://www.mikroe.com}.

% ── Software ────────────────────────────────────────────────────────────
\bibitem{arduinopico}
E.~F. Philhower III \emph{et~al.}, \emph{Arduino-Pico: Raspberry Pi Pico Arduino core for RP2040
and RP2350 boards}. Disponible en: \url{https://github.com/earlephilhower/arduino-pico}.

\bibitem{modbusmaster}
D.~Walker, \emph{ModbusMaster: Enlighten your Arduino to be a Modbus master}.
Disponible en: \url{https://github.com/4-20ma/ModbusMaster}.

\bibitem{fastapi}
S.~Ramírez, \emph{FastAPI}. Disponible en: \url{https://fastapi.tiangolo.com}.

\bibitem{uvicorn}
Encode OSS, \emph{Uvicorn: an ASGI web server}. Disponible en: \url{https://www.uvicorn.org}.

\bibitem{pyserial}
C.~Liechti, \emph{pySerial}. Disponible en: \url{https://github.com/pyserial/pyserial}.

\bibitem{chartjs}
Chart.js contributors, \emph{Chart.js}. Disponible en: \url{https://www.chartjs.org}.

\bibitem{kicad}
KiCad Project, \emph{KiCad EDA 9.0}. Disponible en: \url{https://www.kicad.org}.

\bibitem{matplotlib}
J.~D. Hunter, ``Matplotlib: A 2D graphics environment,'' \emph{Computing in Science \&
Engineering}, vol.~9, n.º~3, pp.~90--95, 2007.

\end{thebibliography}
