javilxpez/TFG_Javi_lopez/LATEX plantilla TFG ETSIDI v3/plantilla TFG ETSIDI v3 En desarrollo/capitulos/anexo.tex

\appendix

\chapter{Anexo: Documentación de la librería Travis}

{\Large Se muestra a continuación la documentación del código de la librería Travis, realizada con un generador de documentación automático. En nuestro caso, el documentador elegido es Doxygen.}
