javilxpez/TFG_Javi_lopez/LATEX plantilla TFG ETSIDI v3/plantilla TFG ETSIDI v3 En desarrollo/capitulos/conclusion.tex

\chapter{Conclusiones}

Se presentan a continuación las conclusiones...

\section{Conclusión}

Una vez finalizado el proyecto...

\section{Desarrollos futuros}

Un posible desarrollo...
