javilxpez/TFG_Javi_lopez/memoria/figuras/modelo_perfiles.pdf

90 45
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
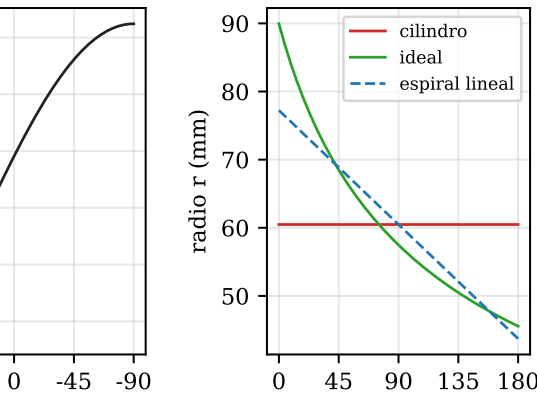
[picture p17: figure]
radio r (mm); cilindro ideal espiral lineal

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
tensión T (N)

0 | 45 90 135 180 giro del tambor φ (°)
0 | 45 90 135 180 giro del tambor φ (°)

2

2,53

par en el tambor τ (N·m)
