javilxpez/TFG_Javi_lopez/memoria/figuras/repetibilidad.pdf

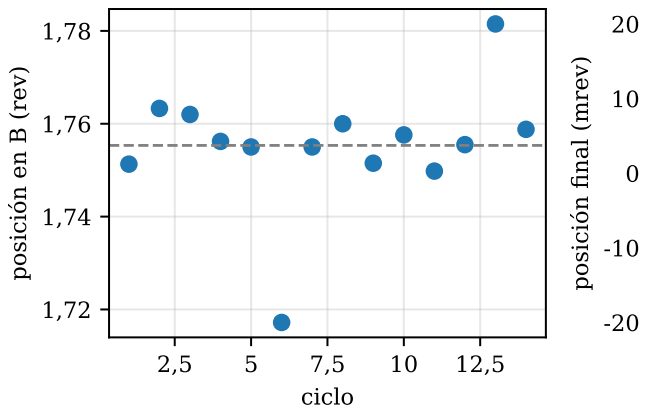
[picture p18: figure]
ciclo; posición en B (rev); posición final (mrev)

2,5

5 | 7,5 | 10 12,5
| ciclo
