javilxpez/TFG_Javi_lopez/memoria/figuras/temporizacion.pdf

50 | 50,5 | 51
periodo entre muestras (ms)

10

100

1000
nº de muestras

10,85 10,9 10,95 11
tiempo de trabajo del lazo (ms)

0

200

400

600

800

nº de muestras
