javilxpez/TFG_Javi_lopez/WhatsApp Image 2026-09-30 at 19.09.52 (2).jpeg

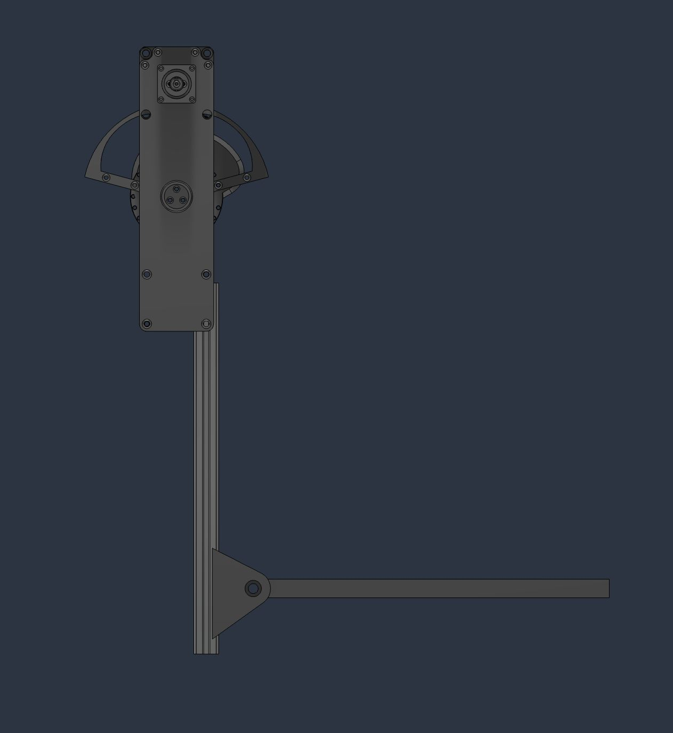
WhatsApp Image 2026-09-30 at 19.09.52 (2).jpeg
