javilxpez/TFG_Javi_lopez/memoria/_v1/anexos/E_manual.tex

\chapter{Manual de uso}
\label{anx:manual}

\section{Instalación}

\subsection{Firmware}
\begin{enumerate}
  \item Instalar Arduino IDE y añadir en \emph{Preferencias} el gestor de placas de Arduino-Pico:\\
        \url{https://github.com/earlephilhower/arduino-pico/releases/download/global/package_rp2040_index.json}
  \item Instalar el paquete \emph{Raspberry Pi Pico/RP2040/RP2350} y la biblioteca
        \emph{ModbusMaster} desde el gestor de bibliotecas.
  \item Abrir \fichero{firmware\_posicion\_v2/firmware\_posicion\_v2.ino} y seleccionar la placa
        \emph{Raspberry Pi Pico 2}.
  \item Conectar la Pico con el botón BOOTSEL pulsado y cargar el programa.
\end{enumerate}

\subsection{Aplicación de supervisión}
\begin{lstlisting}[language=bash,numbers=none]
python3 -m venv .venv
source .venv/bin/activate
pip install fastapi "uvicorn[standard]" pyserial
python web_monitor.py            # o: python web_monitor.py /dev/ttyACM0
\end{lstlisting}
En Linux, la cuenta de usuario debe pertenecer al grupo \codigo{dialout} para acceder al puerto. La
interfaz se abre en \url{http://localhost:8080}.

\section{Procedimiento de ensayo}

\begin{enumerate}
  \item \textbf{Comprobaciones previas}: masa colgada, cable sin cocas, finales de carrera en reposo
        (LED apagados en la interfaz), zona de movimiento despejada.
  \item \textbf{Inicializar}: pestaña \emph{Servo}, dirección 1, botón \emph{Init}. El estado pasa a
        STOPPED y el indicador del servo a conectado.
  \item \textbf{Homing}: fijar la velocidad de \emph{homing} y el desplazamiento del origen, pulsar
        \emph{Aplicar parámetros} y después \emph{Home}. Al terminar se muestra el recorrido A$\rightarrow$B.
  \item \textbf{Tara y calibración}: con la masa en la posición de referencia, pulsar \emph{Tara};
        introducir en la pestaña \emph{Célula 1} la calibración (cuentas/N) y la fuerza real en el
        punto de tara, y aplicar.
  \item \textbf{Ciclo}: en la pestaña \emph{Ciclo A$\leftrightarrow$B}, elegir el punto B, la velocidad
        y las repeticiones, y pulsar \emph{Iniciar ciclo}. La grabación empieza y termina sola.
  \item \textbf{Análisis}: botón \emph{Ver ensayos}; abrir el fichero y, si se desea, desplegar
        \emph{superponer curva teórica} e introducir la geometría.
  \item \textbf{Fin}: \emph{Shutdown} para deshabilitar el accionamiento.
\end{enumerate}

\section{Programación de la célula de carga}

Con el eje parado, abrir \emph{Configuración avanzada} en la pestaña de la célula, elegir la ganancia y
el cero del A/D y pulsar \emph{Programar}. El eje queda bloqueado cerca de un segundo. El resultado
aparece debajo; si es ``sigue alimentada con el reset abajo'', usar \emph{Mantener reset} y medir la
tensión de alimentación de la placa Click, que debe caer a \SI{0}{\volt}.

\section{Diagnóstico}

\begin{longtable}{@{}L{0.34\textwidth}L{0.6\textwidth}@{}}
\toprule
Síntoma & Causa probable y acción \\
\midrule
\endhead
Servo desconectado, lecturas con código 0xE2 & Tiempo de espera Modbus: revisar el cableado A/B, la masa común, la dirección y la velocidad del accionamiento. Probar con \fichero{test\_modbus\_scan}. \\
Código 0xE3 & CRC incorrecto: ruido o polaridad A/B invertida. \\
Estado ERROR con código 0x03 & Tres fallos de configuración: el accionamiento no acepta las escrituras (¿alimentado?, ¿alarma activa?). \\
Final de carrera siempre activo & Contacto abierto o cable roto (entrada NC). \\
Célula no válida & Sin lecturas frescas en \SI{150}{\milli\second}: revisar la placa Click y el bus I\textsuperscript{2}C con \fichero{test\_loadcell}. \\
La interfaz no muestra datos & Comprobar el puerto en la barra superior y el fichero \fichero{web\_monitor.log}. \\
\bottomrule
\end{longtable}

\section{Precauciones}
\begin{itemize}
  \item Las protecciones son de software: mantener las manos fuera del recorrido con el servo
        habilitado y tener a mano el corte de alimentación del accionamiento.
  \item No programar la célula ni usar \emph{Mantener reset} con carga en movimiento (el firmware lo
        impide, pero la medida de fuerza queda interrumpida).
  \item El servidor acepta órdenes de cualquier equipo de la red: usarlo en una red de confianza.
\end{itemize}
