javilxpez/TFG_Javi_lopez/memoria/figuras/n14_tambor.pdf

70

80

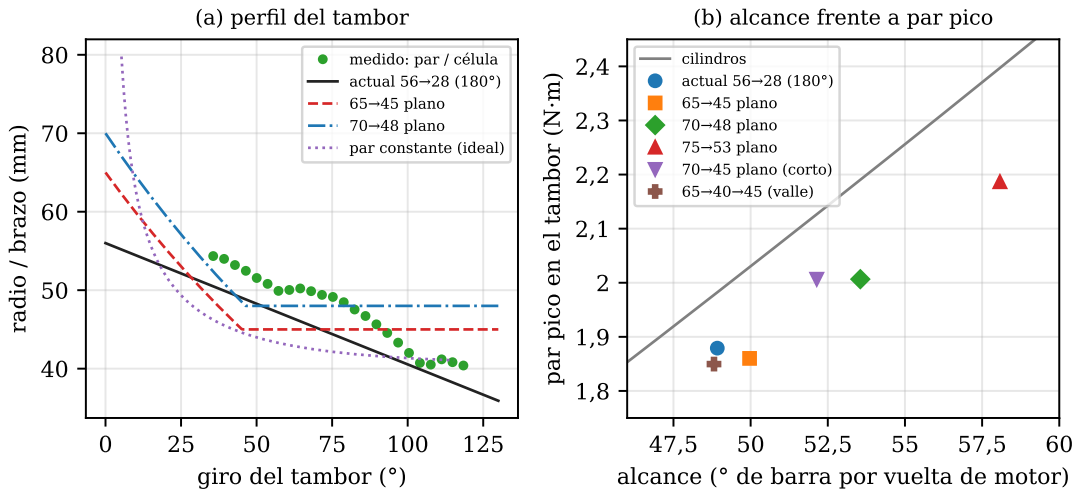
[picture p22: page 1]
alcance (° de barra por vuelta de motor); cilindros

(a) perfil del tambor

(b) alcance frente a par pico

medido: par / célula

actual 56→28 (180°) 65→45 plano 70→48 plano

par pico en el tambor (N·m)

radio / brazo (mm)

par constante (ideal)

75→53 plano 70→45 plano (corto)

65→40→45 (valle)

giro del tambor (°)
