javilxpez/TFG_Javi_lopez/memoria/figuras/n14_descomposicion.pdf

10

20

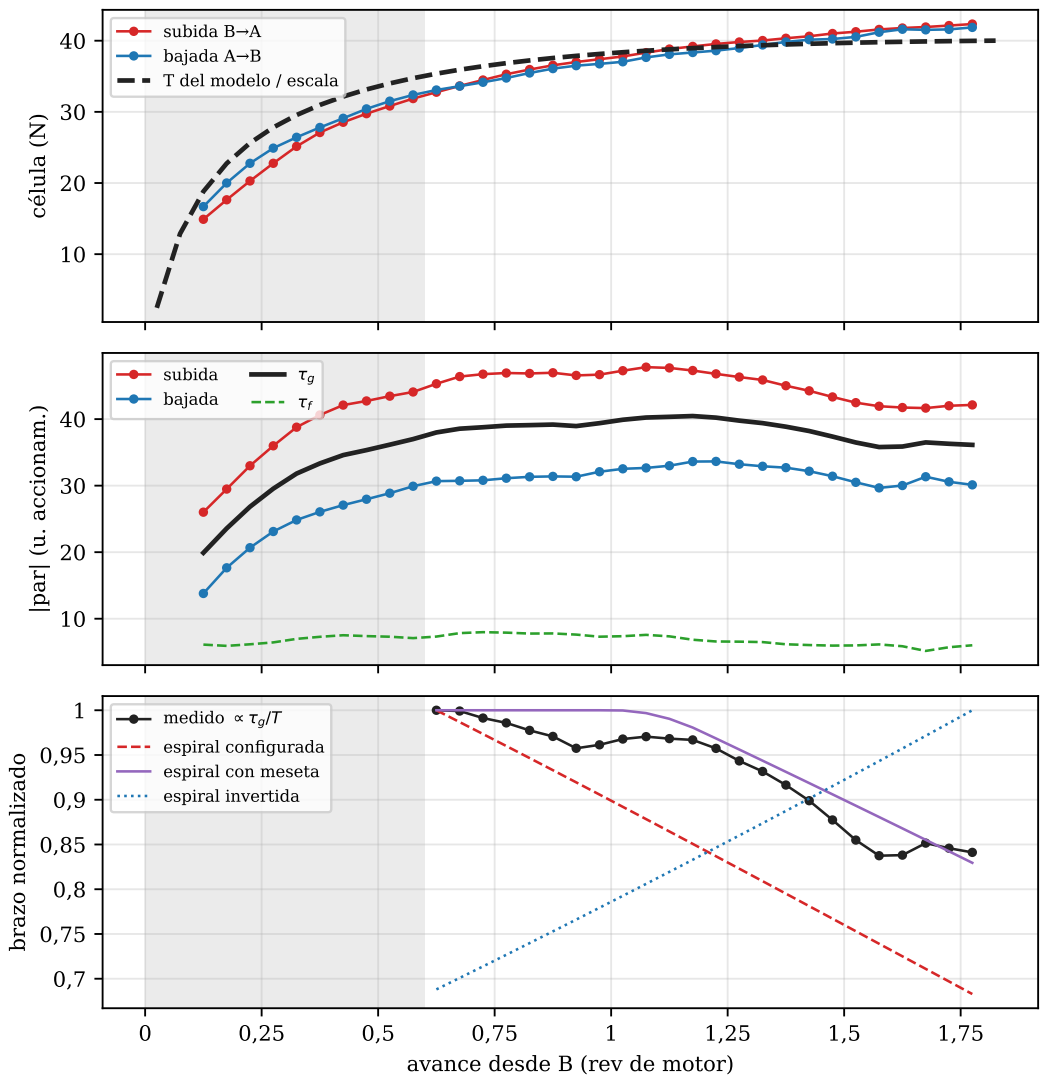
[picture p23: page 1]
célula (N); |par| (u. accionam.); subida; bajada; brazo normalizado

subida B→A
bajada A→B T del modelo / escala

medido ∝ τg/T espiral configurada

espiral con espiral invertida | meseta

avance desde B (rev de motor)
