javilxpez/TFG_Javi_lopez/memoria/figuras/n14_ensayo_tipo.pdf

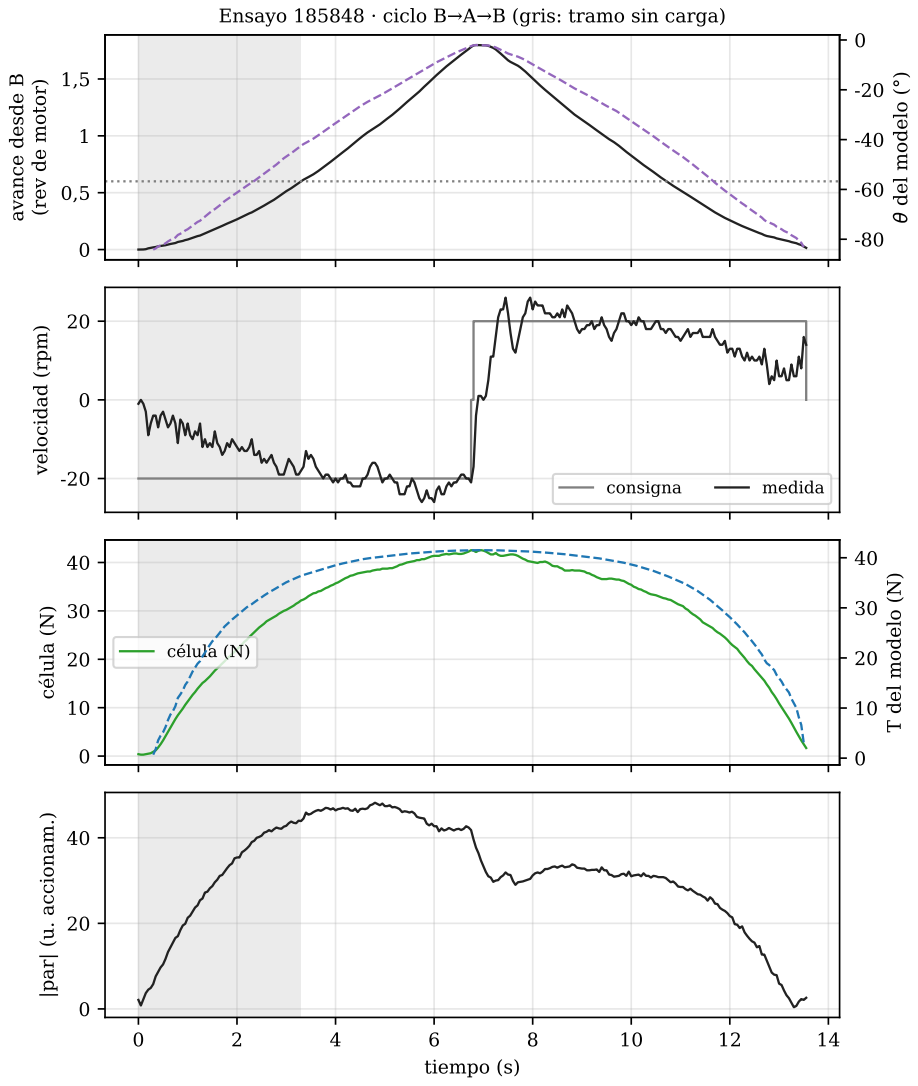
[picture p24: page 1]
avance desde B; velocidad (rpm); consigna; medida; célula (N); tiempo (s); |par| (u. accionam.); del m; delo (°); T del modelo (N)

Ensayo 185848 · ciclo B→A→B (gris: tramo sin carga)

(rev de motor)
