javilxpez/TFG_Javi_lopez/memoria/figuras/n14_modelo.pdf

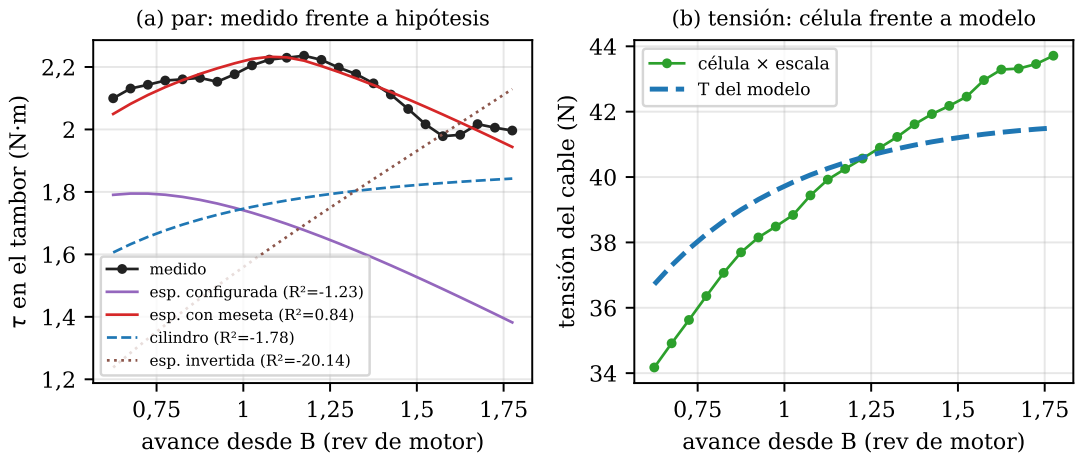
[picture p25: page 1]
célula × escala T del modelo

(a) par: medido frente a hipótesis

(b) tensión: célula frente a modelo

tensión del cable (N)

medido esp. configurada (R²=-1.23) esp. con meseta (R²=0.84)

cilindro (R²=-1.78) esp. invertida (R²=-20.14)

avance desde B (rev de motor)
