javilxpez/TFG_Javi_lopez/memoria/figuras/n_excentrico.pdf

0,91

## (a) ¿qué per

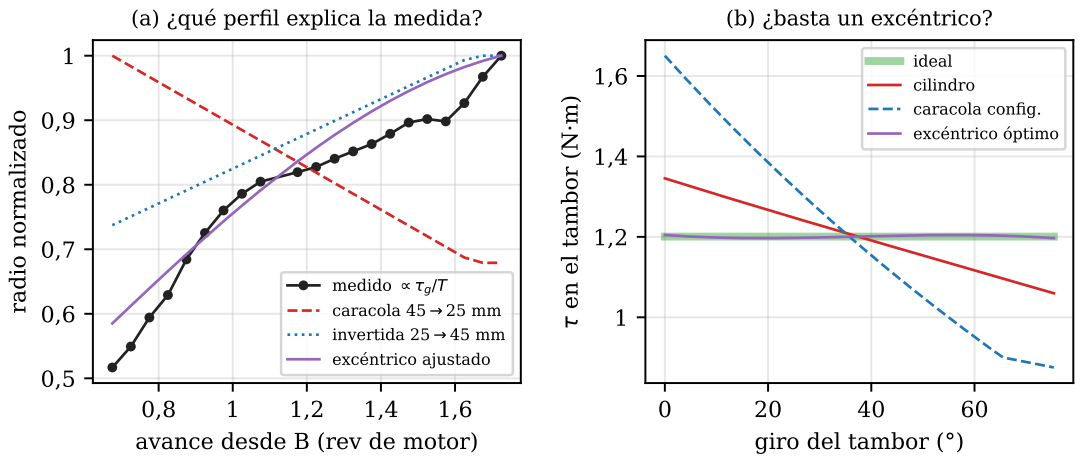
[picture p26: page 1]
radio normalizado

fil explica la medida? medido ∝ τg/T caracola 45 → 25 m

(b) ¿basta un excéntrico?

ideal
cilindro caracola con excéntrico óptimo | fig.

τ en el tambor (N·m)

i n v e r t excéntrico ajustado | i d a 2 5 → 4 | 5 m m

avance desde B (rev de motor)

giro del tambor (°)
