javilxpez/TFG_Javi_lopez/memoria/figuras/n_cilindro.pdf

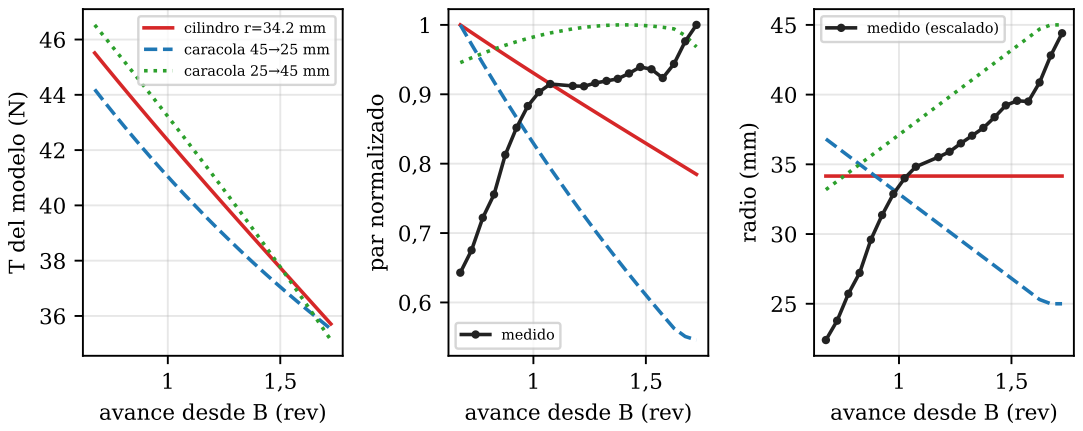
[picture p27: page 1]
T del modelo (N); cilindro r=34.2 mm caracola 45→25 mm caracola 25→45 mm; par normalizado; radio (mm); medido (escalado)

medido
avance desde B (rev)
