javilxpez/TFG_Javi_lopez/memoria/figuras/n_descomposicion.pdf

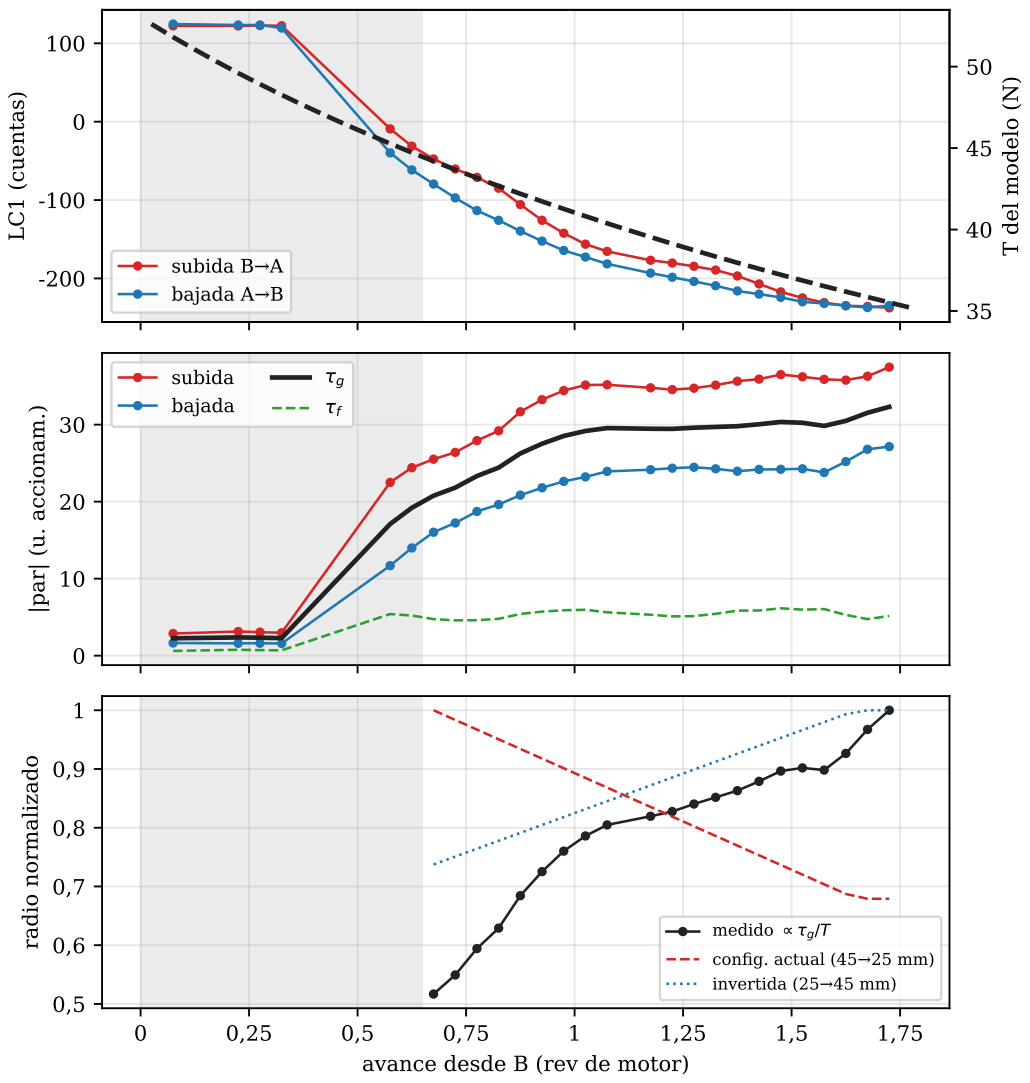
[picture p28: page 1]
LC1 (cuentas); |par| (u. accionam.); subida; bajada; radio normalizado; T del modelo (N)

subida B→A
bajada A→B

medido ∝ τg/T

config. actual (45→25 mm) invertida | (25→45 mm)

avance desde B (rev de motor)
