javilxpez/TFG_Javi_lopez/memoria/figuras/n_ensayo_tipo.pdf

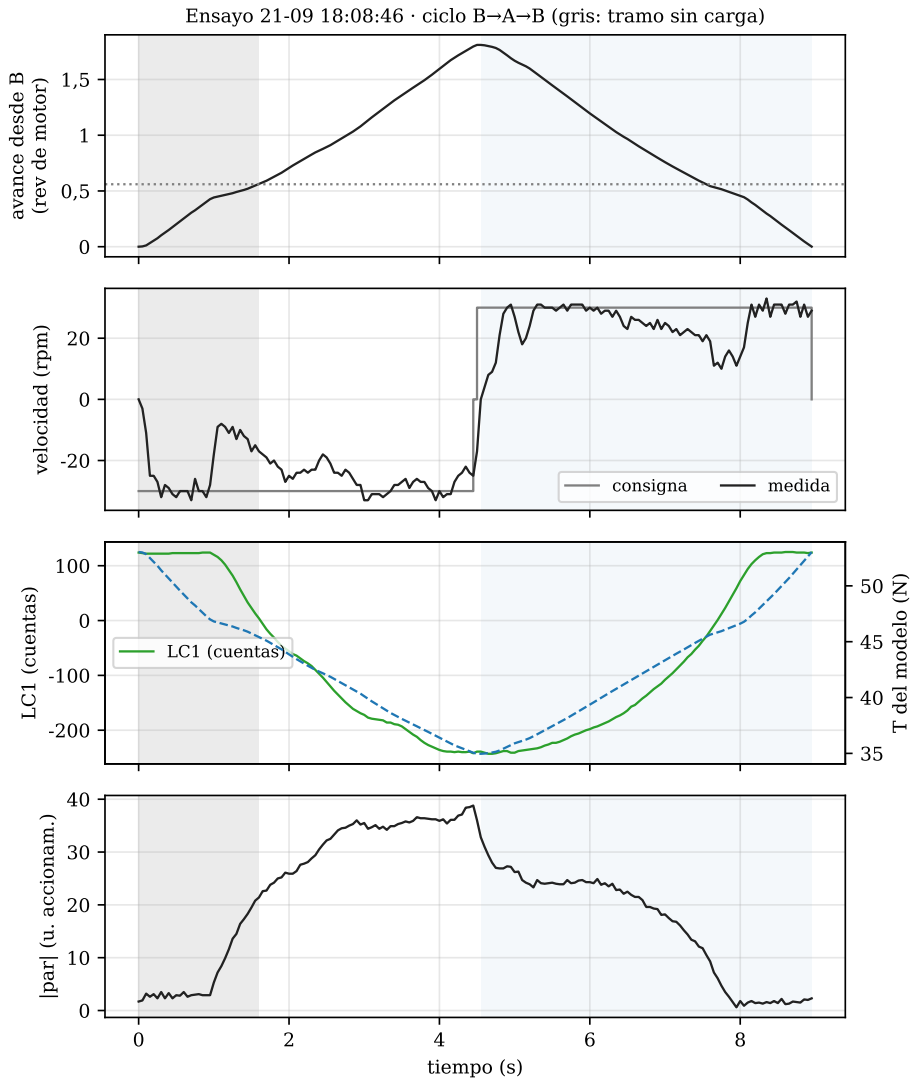
[picture p29: page 1]
avance desde B; velocidad (rpm); consigna; medida; LC1 (cuentas); tiempo (s); |par| (u. accionam.); T del modelo (N)

Ensayo 21-09 18:08:46 · ciclo B→A→B (gris: tramo sin carga)

(rev de motor)
