javilxpez/TFG_Javi_lopez/memoria/figuras/descomposicion_par.pdf

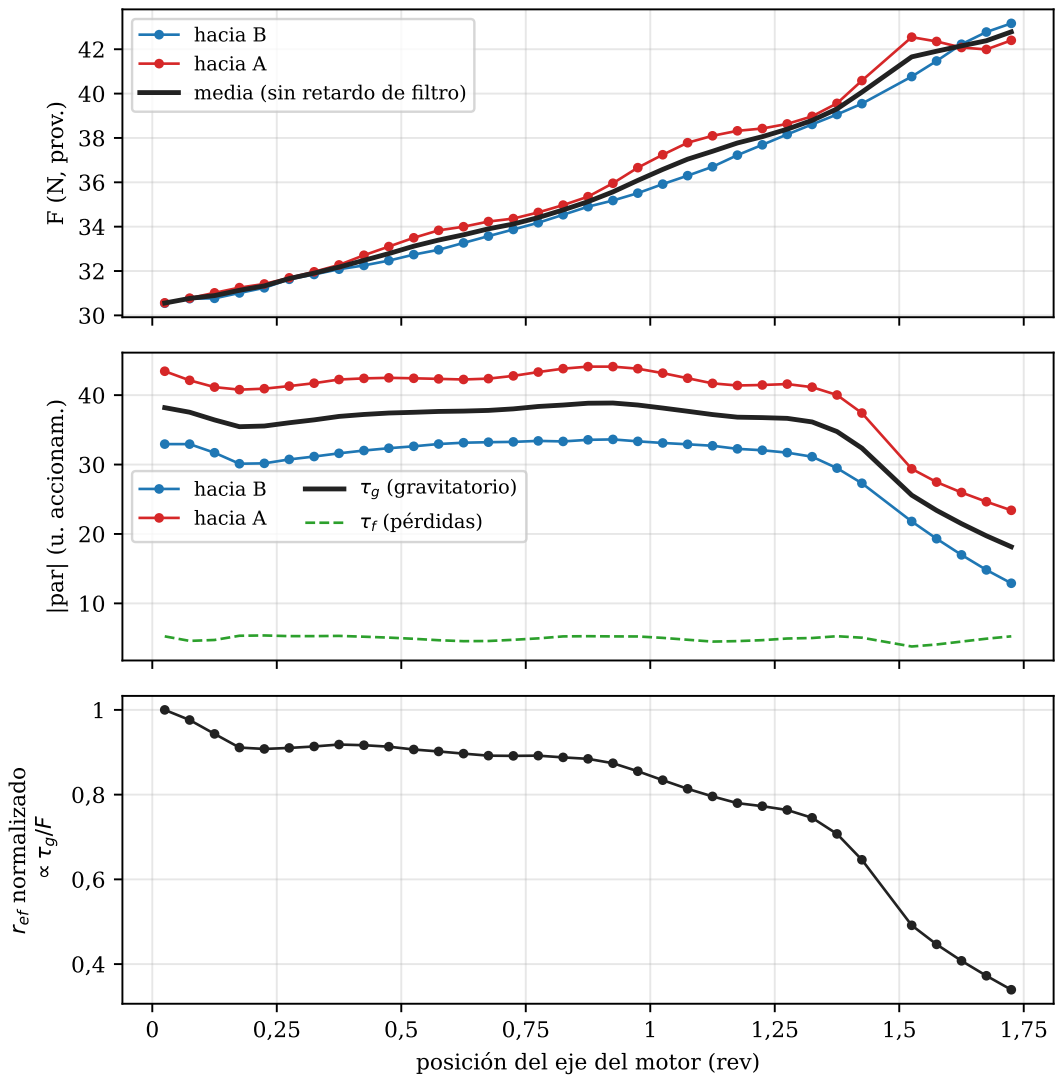
[picture p30: page 1]
F (N, prov.); |par| (u. accionam.); hacia B; hacia A; τg (gravitatorio); τf (pérdidas); ref n; orm; aliza

hacia B
hacia A media (sin retardo de filtro)

posición del eje del motor (rev)
