javilxpez/TFG_Javi_lopez/memoria/figuras/efecto_velocidad.pdf

40

45

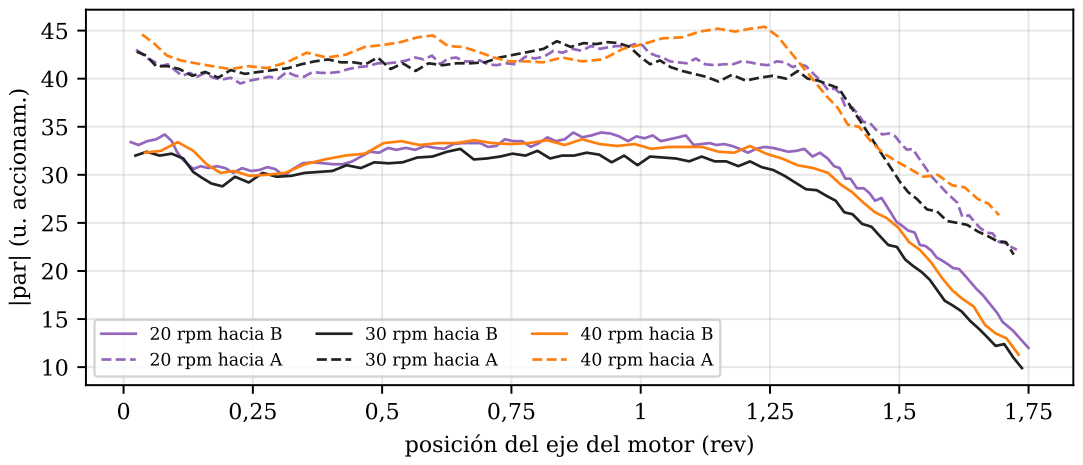
[picture p31: page 1]
|par| (u. accionam.); 20 rpm hacia B 20 rpm hacia A; 30 rpm hacia B 30 rpm hacia A; 40 rpm hacia B 40 rpm hacia A

posición del eje del motor (rev)
