javilxpez/TFG_Javi_lopez/memoria/figuras/ensayo_tipo.pdf

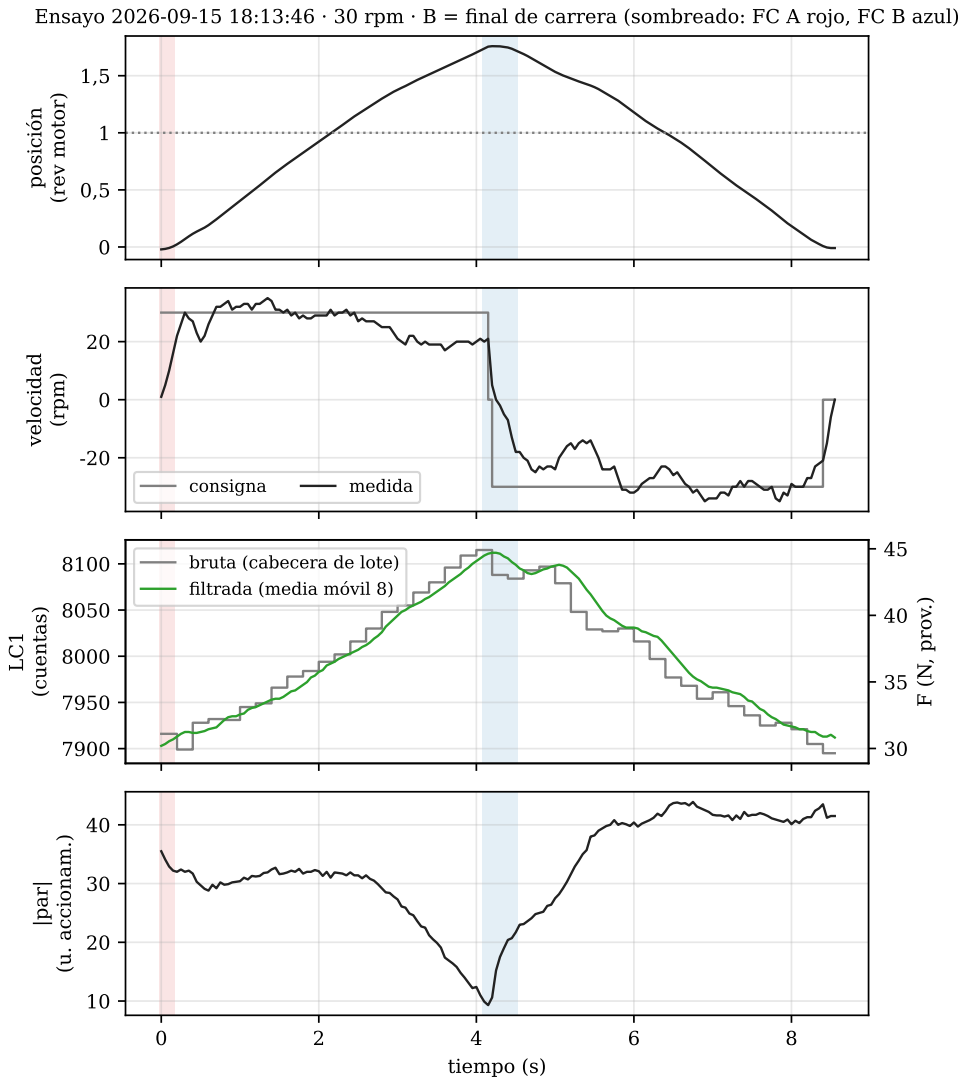
[picture p32: page 1]
posición; (rev motor); velocidad; (rpm); consigna; medida; (cuentas); filtrada (media; móvil 8); tiempo (s); |par|; (u. accionam.); F (N, prov.)

Ensayo 2026-09-15 18:13:46 · 30 rpm · B = final de carrera (sombreado: FC A rojo, FC B azul)

bruta (cabecera de lote)
