javilxpez/TFG_Javi_lopez/memoria/figuras/fuerza_par_posicion.pdf

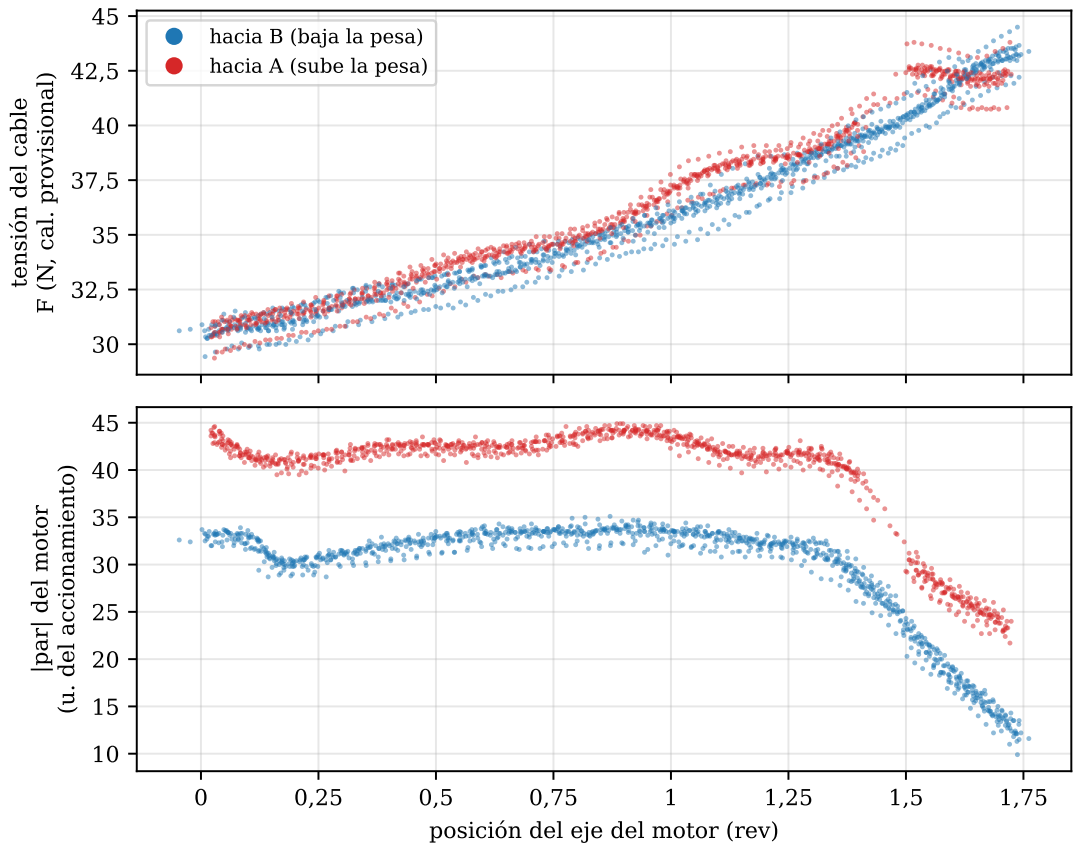
[picture p33: page 1]
F (N, cal. provisional); (u. del accionamiento)

hacia B (baja la pesa)
hacia A (sube la pesa)

tensión del cable

par| del motor

posición del eje del motor (rev)
