javilxpez/TFG_Javi_lopez/memoria/figuras/n_fuerza_par.pdf

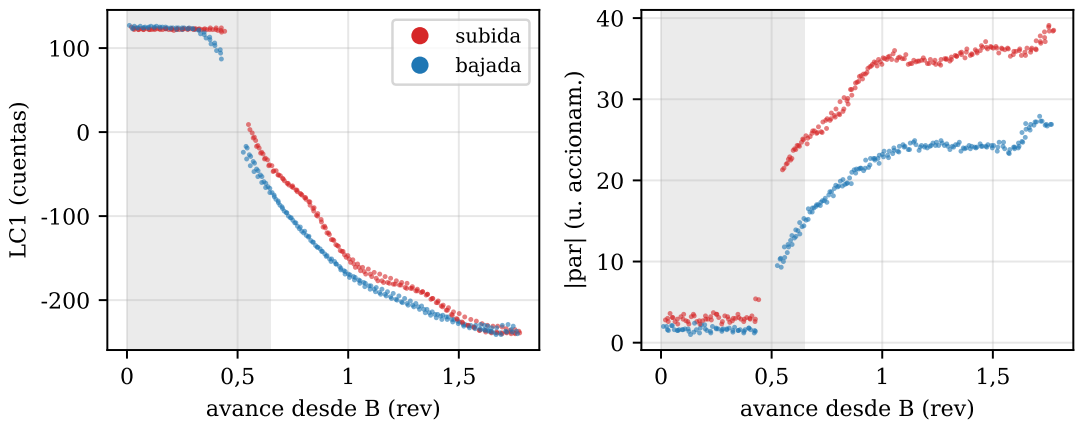
[picture p34: page 1]
LC1 (cuentas); |par| (u. accionam.)

subida
bajada

avance desde B (rev)
