javilxpez/TFG_Javi_lopez/memoria/figuras/n_perfiles.pdf

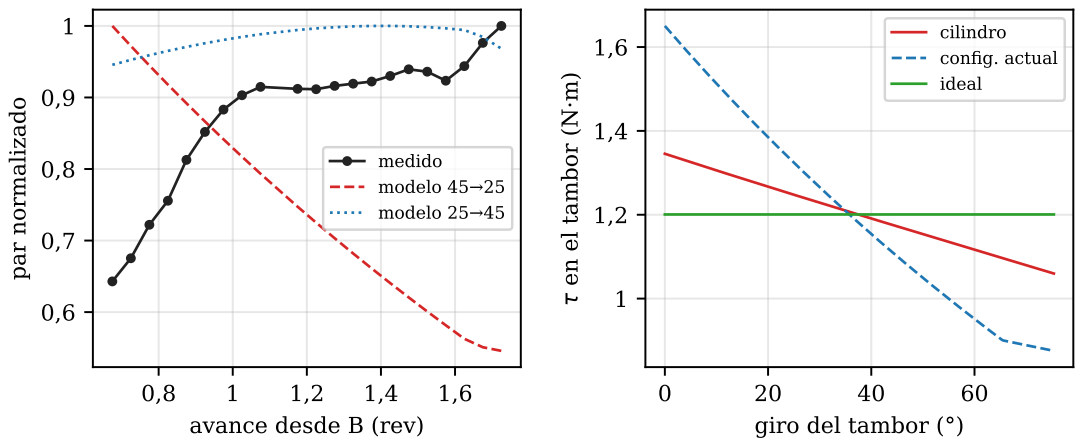
[picture p35: page 1]
par normalizado

cilindro
con ideal | fig. actual

τ en el tambor (N·m)

medido
modelo 45 modelo 25 | →25 →45

avance desde B (rev)

giro del tambor (°)
