javilxpez/TFG_Javi_lopez/tfg_adaptador/tfg_adaptador.kicad_pcb

## KiCad design tfg_adaptador/tfg_adaptador.kicad_pcb (2026-06-20)

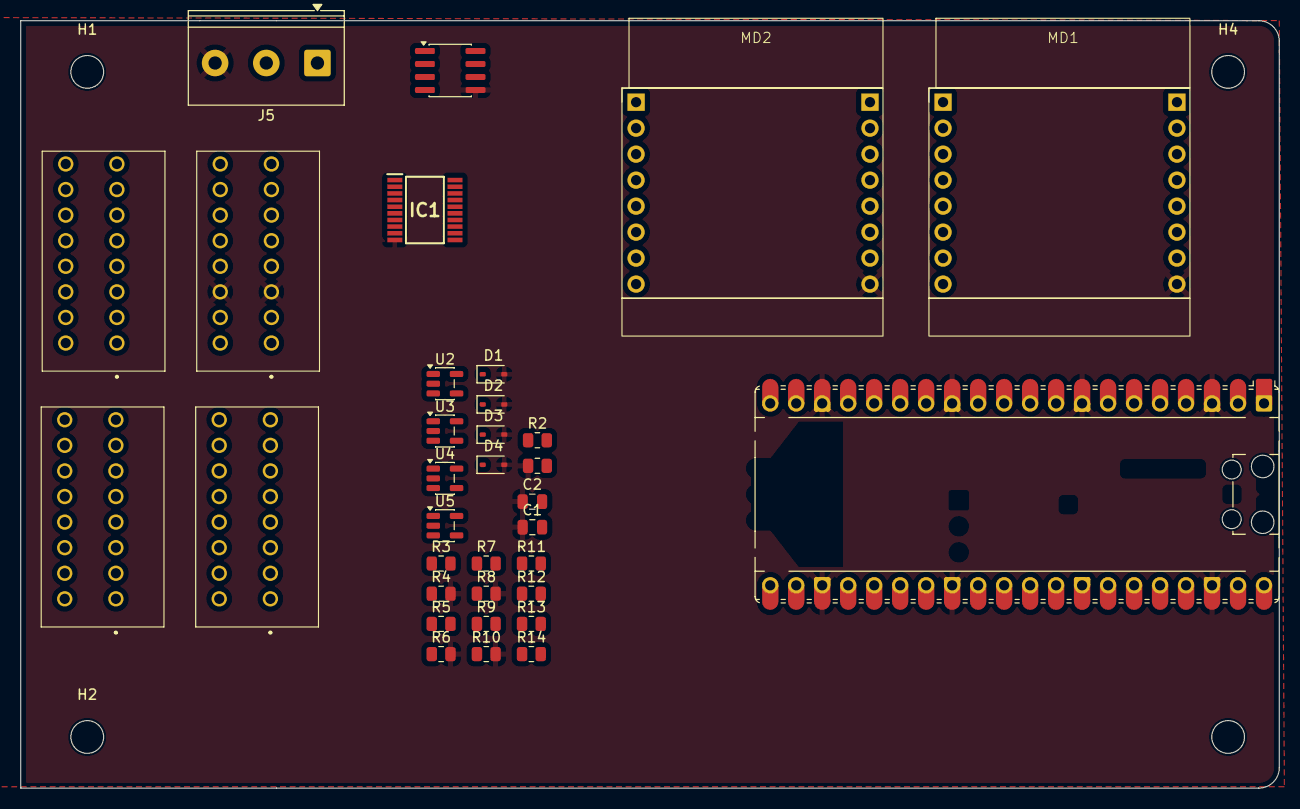
[picture p36: board tfg_adaptador.kicad_pcb from above]

Board: 2 copper layers, 123.0 x 75.0 mm, 38 parts (0 on the bottom side), 30 nets, no tracks yet.

Parts:
A1: RaspberryPi_Pico; RaspberryPi_Pico_Common_Unspecified
C1, C2: 100nf; C_0805_2012Metric
D1, D2, D3, D4: BZX384xxxx; D_SOD-323
H1, H2, H3, H4: MountingHole; MountingHole_3.2mm_M3
IC1: TPS4H000AQPWPRQ1; SOP65P640X120-20N
J1, J2, J3, J4: Screw_Terminal_01x08; terminal02x08
J5: Screw_Terminal_01x03; TerminalBlock_Phoenix_PT-1,5-3-5.0-H_1x03_P5.00mm_Horizontal
MD1, MD2: MicroBus_S
R1, R2: 10K; R_0805_2012Metric
R3, R5, R7, R9: 1.7 K; R_0805_2012Metric
R4, R6, R8, R10: 3.3 K; R_0805_2012Metric
R11, R12, R13, R14: 1K; R_0805_2012Metric
U1: THVD1400D; SOIC-8_3.9x4.9mm_P1.27mm
U2, U3, U4, U5: MCP6001-OT; SOT-23-5

Connections:
+3.3V: A1.17 (GPIO13), A1.36 (3V3), C1.2, C2.2, MD1.7 (+3.3V), MD2.7 (+3.3V), R2.1, R2.2, U1.1 (RO), U1.8 (VCC)
+5V: A1.40 (VBUS), IC1.17 (VS_1)
/AOUT1: A1.21 (GPIO16), R3.2, R4.1
/AOUT2: A1.22 (GPIO17), R5.2, R6.1
/AOUT3: A1.24 (GPIO18), R7.2, R8.1
/AOUT4: A1.25 (GPIO19), R9.2, R10.1
/DOUT1: A1.6 (GPIO4), D1.1 (K), R11.2
/DOUT2: A1.7 (GPIO5), D2.1 (K), R12.2
/DOUT3: A1.9 (GPIO6), D3.1 (K), R13.2
/DOUT4: A1.10 (GPIO7), D4.1 (K), R14.2
/SCL1: A1.2 (GPIO1), MD1.13 (SCL)
/SCL2: A1.5 (GPIO3), MD2.13 (SCL)
/SDA1: A1.1 (GPIO0), MD1.14 (SDA)
/SDA2: A1.4 (GPIO2), MD2.14 (SDA)
/SIN1: A1.11 (GPIO8), IC1.1 (IN1)
/SIN2: A1.12 (GPIO9), IC1.2 (IN2)
/SIN3: A1.14 (GPIO10), IC1.3 (IN3)
/SIN4: A1.15 (GPIO11), IC1.4 (IN4)
/SOUT1: IC1.20 (OUT1), J4.8
/SOUT2: IC1.19 (OUT2), J4.7
/SOUT3: IC1.16 (OUT3), J4.6
/SOUT4: IC1.15 (OUT4), J4.5
GND: A1.3 (GND), A1.8 (GND), A1.13 (GND), A1.18 (GND), A1.23 (GND), A1.28 (GND), A1.38 (GND), C1.1, C2.1, D1.2 (A), D2.2 (A), D3.2 (A), D4.2 (A), IC1.10 (GND), J2.3, J5.3, MD1.16 (GND), MD2.16 (GND), R1.1, R4.2, R6.2, R8.2, R10.2, U1.5 (GND)
unnamed: A1.19 (GPIO14), A1.20 (GPIO15), R1.2, U1.2 (~RE), U1.3 (DE), U1.4 (DI)
unnamed: J5.1, U1.6 (A)
unnamed: J5.2, U1.7 (B)
unnamed: R3.1, U2.1, U2.4 (-)
unnamed: R5.1, U3.1, U3.4 (-)
unnamed: R7.1, U4.1, U4.4 (-)
unnamed: R9.1, U5.1, U5.4 (-)
