javilxpez/TFG_Javi_lopez/web_monitor.py

#!/usr/bin/env python3
"""
Web Monitor — Pico 2 + ZSC31014 + Servo
Dashboard en tiempo real vía WebSocket.

Instalar:  pip install fastapi "uvicorn[standard]" pyserial
Ejecutar:  python web_monitor.py [puerto]
Abrir:     http://localhost:8080
"""

import asyncio
import glob
import json
import logging
import math
import os
import struct
import sys
import threading
import time
from collections import deque
from contextlib import asynccontextmanager
from pathlib import Path

import serial
import uvicorn
from fastapi import FastAPI, WebSocket, WebSocketDisconnect
from fastapi.responses import FileResponse, HTMLResponse, JSONResponse
from fastapi.staticfiles import StaticFiles

# ── Logging (console + file) ──────────────────────────────
LOG_FILE = str(Path(__file__).parent / "web_monitor.log")
logging.basicConfig(
    level=logging.INFO,
    format="%(asctime)s.%(msecs)03d %(message)s",
    datefmt="%H:%M:%S",
    handlers=[logging.FileHandler(LOG_FILE), logging.StreamHandler(sys.stdout)],
)
log = logging.getLogger("monitor")

BAUD = 115200
SYNC = bytes([0xAA, 0x55])

# Batched frame: header (14 B) + N × sample (18 B)
HEADER_FMT  = "<BIHBBBBBBB"   # id, base_t, bridge, lc_status, flags, error, servo_id, rpm_st, trq_st, n
HEADER_SIZE = struct.calcsize(HEADER_FMT)   # 14
SAMPLE_FMT  = "<HhhhhBBH"     # dt_ms, rpm, current_x10, ref_cmd, base_read, io, state, work_us
SAMPLE_SIZE = struct.calcsize(SAMPLE_FMT)   # 14

# lc_flags: b0 = LC1 válida, b1 = servo conectado, b2 = config LC1 aplicada,

CMD_INIT = 0x01; CMD_STOP = 0x02; CMD_SET_PARAM = 0x03
CMD_MOVE_A = 0x04; CMD_MOVE_B = 0x05; CMD_SHUTDOWN = 0x06; CMD_HOME = 0x08
CMD_LC_PROGRAM = 0x09; CMD_LC_QUERY = 0x0A; CMD_LC_HOLD = 0x0B
CMD_CYCLE_START = 0x0C; CMD_CYCLE_STOP = 0x0D

PARAM_SPEED = 0x01; PARAM_FORCE_LIMIT = 0x02; PARAM_ZERO_OFFSET = 0x03
PARAM_ACCEL = 0x04; PARAM_DECEL = 0x05; PARAM_STIFFNESS = 0x06; PARAM_FORCE_CALIB = 0x07
PARAM_HOME_OFFSET = 0x08; PARAM_HOMING_SPEED = 0x09

# v2: frame propio de estado de homing
PACKET_ID_HOME = 0x03
HOME_FMT  = "<BiiBB"   # id, pos_mrev, range_mrev, phase, flags
HOME_SIZE = struct.calcsize(HOME_FMT)

# Programación de la célula: modelo pregunta-respuesta. Cada CMD_LC_PROGRAM /
# CMD_LC_QUERY devuelve exactamente un frame de estos, también cuando se rechaza.
# Ciclo A<->B: A es el home, B el final de carrera o una posición elegida
PACKET_ID_CYCLE = 0x05
CYC_FMT  = "<BBHHiii"  # id, fase, hechas, pedidas, pos_mrev, objetivo_mrev, posB_mrev
CYC_SIZE = struct.calcsize(CYC_FMT)
CYC_FMT_V1  = "<BBHHii"          # firmware anterior: la misma trama sin posB
CYC_SIZE_V1 = struct.calcsize(CYC_FMT_V1)
# El ciclo es B → A → B: la fase 1 es la colocación inicial en B, que no se graba.
CYC_PHASE_NAMES = {0: "—", 1: "colocándose en B", 2: "hacia A", 3: "volviendo a B",
                   4: "completado", 5: "abortado"}

PACKET_ID_LC = 0x04
LC_FMT  = "<BBBBBHHBBH" # id, req, res, ganancia, offset, cfg_antes, cfg_después, ack, flags, cfg1
LC_SIZE = struct.calcsize(LC_FMT)
LC_RESULT_NAMES = {
    0: "sin programar",
    1: "grabado y verificado",
    2: "ya estaba así (no se ha escrito)",
    3: "rechazado: el sistema no está parado",
    4: "rechazado: bus ocupado",
    5: "el chip se reinicia pero no da el 0x5A a tiempo",
    6: "fallo: la relectura no coincide",
    7: "lectura de la configuración actual",
    8: "sigue alimentada con el reset abajo y el bus parqueado: hay otro camino",
    9: "la célula no contesta: sin tensión o sin bus",
    10: "reset mantenido para medir — mide ahora el rail de la Click",
}
LC_RESULT_OK = (1, 2, 7, 10)

STATE_NAMES = {0:"IDLE",1:"SCANNING",2:"CONFIGURING",3:"STOPPED",4:"MOVING_A",5:"MOVING_B",6:"ERROR",
               7:"HOMING",8:"PROGRAMANDO"}
MODE_NAMES  = {0:"PARADO",1:"MOV_A",2:"MOV_B"}
HOME_PHASE_NAMES = {0:"—",1:"BUSCANDO A",2:"BUSCANDO B",3:"YENDO A HOME",4:"COMPLETADO",5:"FALLO"}
ERROR_NAMES = {0:"—",1:"Célula de carga no encontrada",2:"Fallo escaneo servo (RS485?)",
               3:"Fallo configuración servo",4:"Límite de fuerza"}
MB_STATUS   = {0x00:"OK",0x01:"IllegalFn",0x02:"IllegalAddr",0x03:"IllegalVal",0x04:"SlaveFail",
               0xE0:"BadSlaveID",0xE1:"BadFn",0xE2:"TIMEOUT",0xE3:"badCRC"}
def mbst(s): return MB_STATUS.get(s, f"0x{s:02X}")

# ── Grabación de ciclos ───────────────────────────────────
# Un CSV por ensayo, abierto y cerrado por los frames PACKET_ID_CYCLE. Se escriben las
# CUENTAS CRUDAS, no newtons: así el ensayo se puede recalibrar después sin repetirlo.
# Las constantes que hagan falta para convertirlas van en la cabecera del propio fichero.
CYCLE_DIR = Path(__file__).parent / "cycles"
CSV_COLS = ("t_ms", "t_rel_s", "rep", "fase", "pos_rev", "lc1_raw", "lc1_base",
            "rpm", "par_x10", "ref_rpm", "lim_a", "lim_b", "estado", "work_us")

rec = {"f": None, "path": None, "t0": None, "rep": 1, "fase": "", "filas": 0}


def rec_open(cy: dict):
    CYCLE_DIR.mkdir(exist_ok=True)
    path = CYCLE_DIR / (time.strftime("%Y%m%d-%H%M%S") + "_ciclo.csv")
    f = path.open("w", encoding="utf-8")
    with shared_lock:
        fc = shared["force_calib"]
        cal, off = shared["lc1_calib"], shared["lc1_offset"]
    f.write(f"# ensayo {time.strftime('%Y-%m-%d %H:%M:%S')}\n")
    # La de verdad es lc1_cuentas_por_N (float, con signo) y su cero en newtons;
    # lc1_int16 queda sólo como referencia de lo que tiene el firmware.
    f.write(f"# lc1_cuentas_por_N={cal}  lc1_cero_N={off}  lc1_int16={fc}\n")
    f.write(f"# repeticiones_pedidas={cy['cyc_target']}  B={cy['cyc_target_rev']:.3f} rev"
            f" ({'posicion' if cy['cyc_target_rev'] > 0 else 'final de carrera'})\n")
    f.write("# lc1_base ya lleva restada la tara del firmware; lc1_raw es cruda\n")
    f.write(",".join(CSV_COLS) + "\n")
    rec.update(f=f, path=path, t0=None, rep=1, fase="", filas=0)
    log.info("REC   abierto %s", path.name)


def rec_close(motivo: str):
    if not rec["f"]:
        return
    rec["f"].close()
    log.info("REC   cerrado %s (%d filas, %s)", rec["path"].name, rec["filas"], motivo)
    rec.update(f=None)


def rec_row(d: dict, pos_rev: float):
    if not rec["f"]:
        return
    t = d["t_ms"]
    if rec["t0"] is None:
        rec["t0"] = t
    rec["f"].write("%d,%.3f,%d,%s,%.4f,%d,%d,%d,%d,%d,%d,%d,%d,%d\n" % (
        t, (t - rec["t0"]) / 1000.0, rec["rep"], rec["fase"], pos_rev,
        d["bridge"], d["base_read"], d["rpm"], d["current_x10"],
        d["ref_cmd"], 1 if d["io"] & 0x01 else 0, 1 if d["io"] & 0x02 else 0,
        d["servo_state"], d["work_us"]))
    rec["filas"] += 1


# ── Estado compartido (serial thread → async broadcaster) ──
msg_deque: deque = deque(maxlen=100)   # thread-safe single-producer single-consumer
clients: set[WebSocket] = set()

shared = {
    "port": None,
    "pos_rev": 0.0,
    "last_t": None,
    "force_calib": 0,
    "count": 0,
    "rate": 0.0,
    "home_range_rev": 0.0,
    "home_phase": 0,
    "home_range_valid": False,
    "lc_gain": None,       # lo que el firmware dice que hay grabado en la célula
    "lc_offset": None,
    # Medido colgando y descolgando la pesa de 2 kg en los dos extremos del recorrido:
    # abajo 8325 → 8275 cuentas, arriba 8330 → 7900. Son 50 y 430 cuentas para los mismos
    # 19.6 N, y dan la misma constante con un 1% de diferencia. Las cuentas BAJAN al tirar,
    # de ahí el signo. El 14.41 anterior venía de un ajuste y comprimía la curva 5 veces.
    "lc1_calib": -10.2,    # cuentas/N (negativa: las cuentas bajan al aumentar la tensión)
    "lc1_offset": 0.0,     # N reales en el punto donde se puso la tara (tara sin pesa)
}
shared_lock = threading.Lock()
# Última fase de ciclo registrada, para escribir una línea sólo cuando cambia. La escribe
# únicamente el hilo del puerto serie.
cyc_log = {"phase": None}
ser_ref: list = [None]   # contenedor mutable para la referencia al puerto serie

# ── Protocolo ─────────────────────────────────────────────
def crc8(data: bytes) -> int:
    crc = 0
    for b in data:
        crc ^= b
        for _ in range(8):
            crc = ((crc << 1) ^ 0x07) & 0xFF if crc & 0x80 else (crc << 1) & 0xFF
    return crc

def build_packet(payload: bytes) -> bytes:
    return SYNC + bytes([len(payload)]) + payload + bytes([crc8(payload)])

def decode_home(payload: bytes) -> dict | None:
    """v2: frame de estado de homing (PACKET_ID_HOME)."""
    if len(payload) < HOME_SIZE or payload[0] != PACKET_ID_HOME:
        return None
    _pid, pos_mrev, range_mrev, phase, flags = struct.unpack(HOME_FMT, payload[:HOME_SIZE])
    return {"home_pos_rev": pos_mrev / 1000.0, "home_range_rev": range_mrev / 1000.0,
            "home_phase": phase, "home_range_valid": bool(flags & 0x01)}

def decode_cycle(payload: bytes) -> dict | None:
    """Estado del ciclo B → A → B (PACKET_ID_CYCLE)."""
    if payload[:1] != bytes([PACKET_ID_CYCLE]):
        return None
    # Se acepta la trama del firmware anterior (sin posB) para que un firmware desparejado
    # siga informando de la fase en vez de quedarse mudo, que es justo lo que despistó al
    # depurar el ciclo.
    if len(payload) >= CYC_SIZE:
        _pid, phase, done, target, pos_mrev, tgt_mrev, pos_b_mrev = \
            struct.unpack(CYC_FMT, payload[:CYC_SIZE])
    elif len(payload) >= CYC_SIZE_V1:
        _pid, phase, done, target, pos_mrev, tgt_mrev = \
            struct.unpack(CYC_FMT_V1, payload[:CYC_SIZE_V1])
        pos_b_mrev = 0
    else:
        return None
    return {"cyc_phase": phase, "cyc_phase_name": CYC_PHASE_NAMES.get(phase, "?"),
            "cyc_done": done, "cyc_target": target,
            "cyc_pos_rev": pos_mrev / 1000.0, "cyc_target_rev": tgt_mrev / 1000.0,
            "cyc_pos_b_rev": pos_b_mrev / 1000.0}


def decode_lc(payload: bytes) -> dict | None:
    """Respuesta a CMD_LC_PROGRAM / CMD_LC_QUERY (PACKET_ID_LC)."""
    if len(payload) < LC_SIZE or payload[0] != PACKET_ID_LC:
        return None
    (_pid, req, result, gain, offset,
     cfg_before, cfg_after, ack, flags, cfg1) = struct.unpack(LC_FMT, payload[:LC_SIZE])
    return {"lc_req": req, "lc_result": result,
            "lc_result_name": LC_RESULT_NAMES.get(result, f"?{result}"),
            "lc_ok": result in LC_RESULT_OK,
            "lc_gain": gain, "lc_offset": offset,
            "lc_cfg_before": cfg_before, "lc_cfg_after": cfg_after,
            "lc_ack": ack,
            # Si el pin de reset no corta, la EEPROM se graba igual pero el valor nuevo
            # no se carga hasta que el chip pase por un apagado de verdad.
            "lc_en_cuts": bool(flags & 0x01),
            # Retardo del barrido con el que se logró entrar en modo comando, en µs:
            # es el dato que dice cuánto tarda de verdad en arrancar esta Click.
            "lc_entry_us": ((flags >> 4) & 0x0F) * 150,
            "lc_cfg1": cfg1}


def decode_packet(payload: bytes) -> list | None:
    """Batched frame → list of per-sample dicts (each looks like the old single packet)."""
    if len(payload) < HEADER_SIZE or payload[0] != 0x02:
        return None
    (_pid, base_t, bridge, lc_status, lc_flags, error, servo_id,
     rpm_status, trq_status, n) = struct.unpack(HEADER_FMT, payload[:HEADER_SIZE])
    out = []
    off = HEADER_SIZE
    for _ in range(n):
        if off + SAMPLE_SIZE > len(payload):
            break
        (dt, rpm, cur, ref, base, io, state,
         work_us) = struct.unpack(SAMPLE_FMT, payload[off:off + SAMPLE_SIZE])
        off += SAMPLE_SIZE
        out.append({
            "t_ms": (base_t + dt) & 0xFFFFFFFF, "work_us": work_us,
            "rpm": rpm, "current_x10": cur, "ref_cmd": ref, "base_read": base,
            "io": io, "servo_state": state,
            "mode": 1 if state == 4 else 2 if state == 5 else 0,
            "bridge": bridge, "lc_status": lc_status, "lc_flags": lc_flags,
            "error": error, "servo_id": servo_id,
            "rpm_status": rpm_status, "trq_status": trq_status,
        })
    return out

def read_packet(ser) -> bytes | None:
    while True:
        b = ser.read(1)
        if not b: return None
        if b[0] == SYNC[0]:
            b2 = ser.read(1)
            if b2 and b2[0] == SYNC[1]: break
    lb = ser.read(1)
    if not lb: return None
    n = lb[0]
    if not n or n > 254: return None
    raw = ser.read(n + 1)
    if len(raw) < n + 1: return None
    payload = raw[:n]
    return payload if raw[n] == crc8(payload) else b"CRC_ERR"

def find_port() -> str | None:
    for pat in ["/dev/ttyACM*", "/dev/ttyUSB*", "/dev/cu.usbmodem*", "COM*"]:
        ports = sorted(glob.glob(pat))
        if ports: return ports[0]
    return None

# ── Hilo serie ────────────────────────────────────────────
def serial_thread(preferred: str | None):
    rate_window: list[float] = []
    while True:
        port = preferred if (preferred and os.path.exists(preferred)) else find_port()
        if not port:
            time.sleep(1.0)
            continue

        ser = None
        try:
            ser = serial.Serial(port, BAUD, timeout=0.1)
            ser_ref[0] = ser
            with shared_lock:
                shared["port"] = port
            time.sleep(0.5)
            ser.reset_input_buffer()
            print(f"# Serial OK: {port}")

            while True:
                payload = read_packet(ser)
                if payload is None or payload == b"CRC_ERR":
                    continue

                if payload and payload[0] == PACKET_ID_CYCLE:  # estado del ciclo A<->B
                    cy = decode_cycle(payload)
                    if cy:
                        ph = cy["cyc_phase"]                    # 2,3 = ensayo en marcha
                        # Una línea por cambio de fase: sin esto, un ciclo que arranca y
                        # termina en 200 ms no deja ni rastro de por dónde pasó.
                        if ph != cyc_log["phase"]:
                            log.info("CYC   fase %d %-17s pos=%7.3f  B=%.3f  hechas=%d/%d  recorrido=%.2f rev",
                                     ph, cy["cyc_phase_name"], cy["cyc_pos_rev"], cy["cyc_pos_b_rev"],
                                     cy["cyc_done"], cy["cyc_target"], cy["cyc_target_rev"])
                            cyc_log["phase"] = ph
                        # La colocación en B (fase 1) no se graba: el ensayo empieza
                        # cuando el eje ya está en B y arranca el tramo B → A.
                        if ph in (2, 3) and rec["f"] is None:
                            rec_open(cy)
                        rec["fase"] = cy["cyc_phase_name"].replace(" ", "_")
                        rec["rep"]  = cy["cyc_done"] + 1
                        if ph not in (2, 3) and rec["f"] is not None:
                            rec_close(cy["cyc_phase_name"])
                        msg = dict(cy); msg["type"] = "cycle"; msg["port"] = port
                        msg["rec"] = rec["path"].name if rec["f"] else None
                        msg_deque.append(msg)
                    continue

                if payload and payload[0] == PACKET_ID_LC:     # respuesta de programación
                    lc = decode_lc(payload)
                    if lc:
                        with shared_lock:
                            shared["lc_gain"]   = lc["lc_gain"]
                            shared["lc_offset"] = lc["lc_offset"]
                        msg = dict(lc)
                        msg["type"] = "lc_config"
                        msg["port"] = port
                        msg_deque.append(msg)
                    continue

                if payload and payload[0] == PACKET_ID_HOME:   # v2: estado de homing
                    hp = decode_home(payload)
                    if hp:
                        with shared_lock:
                            shared["pos_rev"]          = hp["home_pos_rev"]  # firmware manda la posición
                            shared["home_range_rev"]   = hp["home_range_rev"]
                            shared["home_phase"]        = hp["home_phase"]
                            shared["home_range_valid"]  = hp["home_range_valid"]
                        msg = dict(hp)
                        msg["type"]            = "home"
                        msg["pos_rev"]         = round(hp["home_pos_rev"], 5)
                        msg["home_range_rev"]  = round(hp["home_range_rev"], 5)
                        msg["home_phase_name"] = HOME_PHASE_NAMES.get(hp["home_phase"], "?")
                        msg["port"]            = port
                        msg_deque.append(msg)
                    continue

                samples = decode_packet(payload)
                if not samples:
                    continue

                last = samples[-1]
                maxw = max(s["work_us"] for s in samples) / 1000.0
                # Con la posición, los finales de carrera y la fase del ciclo en la misma
                # línea se puede reconstruir por qué un ensayo no avanza sin estar delante
                # de la máquina: es lo que faltaba para diagnosticar el ciclo.
                with shared_lock:
                    pos_log = shared["pos_rev"]
                fase_log = CYC_PHASE_NAMES.get(cyc_log["phase"], "?") if cyc_log["phase"] else "—"
                log.info("FRAME n=%d  st=%-11s rpm=%5d  trq=%6.1f  ref=%5d  pos=%8.3f  "
                         "limA=%d limB=%d  ciclo=%-17s id=%d  RPMrd=%-7s TRQrd=%-7s  loop_max=%.1fms",
                         len(samples), STATE_NAMES.get(last["servo_state"], "?"), last["rpm"],
                         last["current_x10"] / 10.0, last["ref_cmd"], pos_log,
                         1 if last["io"] & 0x01 else 0, 1 if last["io"] & 0x02 else 0,
                         fase_log, last["servo_id"],
                         mbst(last["rpm_status"]), mbst(last["trq_status"]), maxw)

                for data in samples:                       # one loop iteration per sample
                    t_ms = data["t_ms"]
                    # El Pico reinicia su millis() a 0 cada vez que se reflashea o se
                    # resetea. Sin esta comprobación, t_ms da un salto hacia atrás, la
                    # resta de abajo sale negativa, la ventana no se poda NUNCA y crece
                    # sin límite: "3813 Hz" no era el loop, era el número de muestras
                    # acumuladas desde el último reflasheo.
                    if rate_window and not (0 <= t_ms - rate_window[-1] < 5000):
                        rate_window.clear()                # reloj del equipo reiniciado
                        shared["last_t"] = None            # y la integración, rebasada
                    rate_window.append(t_ms)               # rate on DEVICE time → true loop Hz
                    while rate_window and t_ms - rate_window[0] > 1000:
                        rate_window.pop(0)
                    with shared_lock:
                        rpm = data["rpm"]
                        if shared["last_t"] is not None:   # integrate on DEVICE time
                            dt = (t_ms - shared["last_t"]) / 1000.0
                            if 0.0 < dt < 5.0:
                                shared["pos_rev"] += rpm * dt / 60.0
                        shared["last_t"] = t_ms
                        shared["count"] += 1
                        rec_row(data, shared["pos_rev"])
                        pos_rev = shared["pos_rev"]; fc = shared["force_calib"]; cnt = shared["count"]
                        h_range = shared["home_range_rev"]; h_phase = shared["home_phase"]
                        h_valid = shared["home_range_valid"]

                    io = data["io"]; br = data["base_read"]
                    msg = dict(data)
                    msg["pos_rev"]    = round(pos_rev, 5)
                    msg["force_n"]    = round(br / fc, 3) if fc else None
                    msg["state_name"] = STATE_NAMES.get(data["servo_state"], "?")
                    msg["mode_name"]  = MODE_NAMES.get(data["mode"], "?")
                    msg["error_name"] = ERROR_NAMES.get(data["error"], f"cod {data['error']}")
                    msg["limit_a"]    = bool(io & 0x01)
                    msg["limit_b"]    = bool(io & 0x02)
                    msg["rate"]       = len(rate_window)
                    msg["count"]      = cnt
                    msg["port"]       = port
                    msg["home_range_rev"]   = round(h_range, 5)
                    msg["home_phase"]       = h_phase
                    msg["home_phase_name"]  = HOME_PHASE_NAMES.get(h_phase, "?")
                    msg["home_range_valid"] = h_valid
                    msg_deque.append(msg)

                with shared_lock:
                    shared["rate"] = len(rate_window)

        except Exception as e:
            print(f"# Serial error: {e}  (reintentando en 1 s...)")
        finally:
            ser_ref[0] = None
            if ser is not None:
                try: ser.close()
                except Exception: pass
            with shared_lock:
                shared["last_t"] = None   # avoid a huge dt jump across reconnect

        time.sleep(1.0)

# ── Broadcaster WebSocket ─────────────────────────────────
async def broadcaster():
    while True:
        if msg_deque and clients:
            msg = msg_deque.popleft()
            text = json.dumps(msg)
            dead: set[WebSocket] = set()
            for ws in list(clients):
                try:
                    await ws.send_text(text)
                except Exception:
                    dead.add(ws)
            clients.difference_update(dead)
        else:
            await asyncio.sleep(0.02)

# ── FastAPI ───────────────────────────────────────────────
@asynccontextmanager
async def lifespan(app: FastAPI):
    preferred = sys.argv[1] if len(sys.argv) > 1 else None
    threading.Thread(target=serial_thread, args=(preferred,), daemon=True).start()
    asyncio.create_task(broadcaster())
    yield

app = FastAPI(lifespan=lifespan)
# Fanuc Control UI Kit: estilos y fuentes, tal cual vienen. El CSS carga sus fuentes con
# rutas relativas (../fonts/), por eso se publica la carpeta entera y no fichero a fichero.
app.mount("/fui", StaticFiles(directory=Path(__file__).parent / "static" / "fui"), name="fui")

# ── Configuración del mecanismo ──────────────────────────
# Geometría del banco para el modelo teórico. Se edita desde /sim y la lee /ensayos,
# para que el simulador y la curva teórica calculen con los mismos números. Las claves y
# los rangos tienen que coincidir con MEC_DEFAULTS y Mec.validar en static/mecanismo.js.
MECH_FILE = Path(__file__).parent / "mecanismo.json"
# El recorrido A→B del motor no se guarda: sale de barr × red (Mec.recorridoMotor).
MECH_DEFAULTS = {
    "tipo": "car", "L1": 25.0, "r0": 28.18, "r1": 56.0, "barr": 0.367,
    "L2": 290.0, "xt": 30.0, "ob": 30.0, "L3": 95.0, "L4": 110.0, "e1": 20.0, "e2": 20.0, "m": 2.0, "g": 9.81,
    "th0": -87.0, "red": 5.0, "sentido": 1,
    # leva de par constante (tipo 'leva'): par objetivo en el tambor (N·m), radio máximo (mm)
    # y θ hasta el que se diseña (°). Ver Mec.perfilLeva en static/mecanismo.js.
    "tau0": 1.5, "rmax": 70.0, "thfin": 3.0,
}
# (mínimo, máximo, mínimo excluido). th0 es la barra desde la horizontal en el home, y el
# rango de aquí es el del par de ángulos posible; el límite fino (el punto muerto, ≈ −89°)
# depende de la geometría y lo comprueba Mec.thMuerto en el cliente. xt es el eje del
# tambor a la izquierda de O (negativo: a la derecha); el cable sale tangente al tambor,
# por el lado de O. ob es el carril a la izquierda de O y sólo sirve para el dibujo.
# e1 es cuánto tira el cable por encima del eje de la barra y e2 cuánto cuelga la pesa por
# debajo; negativos si van al otro lado.
MECH_RANGOS = {
    "L1": (0, 1e4, True), "r0": (0, 1e4, True), "r1": (0, 1e4, True), "barr": (0, 100, True),
    "L2": (0, 1e4, True), "xt": (-1e4, 1e4, False), "ob": (-1e4, 1e4, False), "L3": (0, 1e4, True), "L4": (0, 1e4, False),
    "e1": (-1e4, 1e4, False), "e2": (-1e4, 1e4, False),
    "m": (0, 1e4, False), "g": (0, 100, False), "th0": (-90, 90, False),
    "red": (0, 1e4, True),
    "tau0": (0, 1e3, True), "rmax": (0, 1e4, True), "thfin": (-90, 90, False),
}


def mech_load() -> dict:
    try:
        data = json.loads(MECH_FILE.read_text())
        # Ficheros guardados con la convención anterior (α entre mástil y barra, y la
        # salida del cable en un punto fijo D a dx de O). La conversión exacta es
        # θ = incD − α, con incD = atan2(L2, −dx) la inclinación de O→D; con dx = 0 se
        # reduce a θ = 90 − α, que era lo que hacía la versión de antes y fallaba en cuanto
        # D se desplazaba. El dx se descarta después: ahora lo que se guarda es el eje del
        # tambor (xt) y el cable sale tangente a él.
        if "th0" not in data and "a0" in data:
            L2 = float(data.get("L2", MECH_DEFAULTS["L2"]))
            dx = float(data.get("dx", 11.0))
            data["th0"] = math.degrees(math.atan2(L2, -dx)) - float(data["a0"])
        return {**MECH_DEFAULTS, **{k: v for k, v in data.items() if k in MECH_DEFAULTS}}
    except FileNotFoundError:
        return dict(MECH_DEFAULTS)
    except Exception as e:
        log.warning("MECH  mecanismo.json ilegible (%s), uso los valores por defecto", e)
        return dict(MECH_DEFAULTS)


def mech_validate(body: dict):
    """Devuelve (config, None) o (None, motivo). Rechaza en vez de recortar: un valor
    recortado en silencio es justo el tipo de error que no se ve en la gráfica."""
    out = mech_load()
    for k, v in body.items():
        if k not in MECH_DEFAULTS:
            return None, f"clave desconocida: {k}"
        if k == "tipo":
            if v not in ("car", "cil", "leva"):
                return None, "tipo tiene que ser 'car', 'cil' o 'leva'"
            out[k] = v
        elif k == "sentido":
            if v not in (-1, 1, "-1", "1"):
                return None, "sentido tiene que ser -1 o 1"
            out[k] = int(v)
        else:
            try:
                f = float(v)
            except (TypeError, ValueError):
                return None, f"{k} no es un número"
            lo, hi, excl = MECH_RANGOS[k]
            if f != f or f > hi or f < lo or (excl and f == lo):
                return None, f"{k} fuera de rango ({lo}{' excluido' if excl else ''} … {hi})"
            out[k] = f
    return out, None


@app.get("/api/mecanismo")
async def get_mech():
    return JSONResponse(mech_load())


@app.put("/api/mecanismo")
async def put_mech(body: dict):
    cfg, err = mech_validate(body)
    if err:
        return JSONResponse({"error": err}, status_code=400)
    # Escritura atómica: un corte a medias no puede dejar un JSON truncado.
    tmp = MECH_FILE.with_suffix(".json.tmp")
    tmp.write_text(json.dumps(cfg, indent=2))
    os.replace(tmp, MECH_FILE)
    log.info("MECH  guardado %s", json.dumps(cfg))
    return JSONResponse(cfg)


@app.get("/sim")
async def sim():
    """Simulador del mecanismo: aquí se configura la geometría que usan las demás páginas."""
    return HTMLResponse((Path(__file__).parent / "static" / "sim.html").read_text())


@app.get("/leva")
async def leva():
    """Leva de par constante: el perfil r = τ0/T con la geometría configurada, frente a
    los cilindros equivalentes y la espiral actual."""
    return HTMLResponse((Path(__file__).parent / "static" / "leva.html").read_text())


@app.get("/mecanismo.js")
async def mecanismo_js():
    return FileResponse(Path(__file__).parent / "static" / "mecanismo.js",
                        media_type="application/javascript",
                        headers={"Cache-Control": "no-cache"})


@app.get("/tema.css")
async def tema_css():
    return FileResponse(Path(__file__).parent / "static" / "tema.css",
                        media_type="text/css", headers={"Cache-Control": "no-cache"})


@app.get("/tema.js")
async def tema_js():
    return FileResponse(Path(__file__).parent / "static" / "tema.js",
                        media_type="application/javascript",
                        headers={"Cache-Control": "no-cache"})


@app.get("/nav.js")
async def nav_js():
    return FileResponse(Path(__file__).parent / "static" / "nav.js",
                        media_type="application/javascript",
                        headers={"Cache-Control": "no-cache"})


@app.get("/ensayos")
async def ensayos():
    """Página aparte para mirar los ciclos ya grabados, sin tocar el monitor en vivo."""
    return HTMLResponse((Path(__file__).parent / "static" / "ensayos.html").read_text())


@app.get("/cycles")
async def list_cycles():
    """Los ensayos grabados, el más reciente primero."""
    CYCLE_DIR.mkdir(exist_ok=True)
    files = sorted(CYCLE_DIR.glob("*.csv"), key=lambda p: p.stat().st_mtime, reverse=True)
    return JSONResponse([{"name": f.name, "bytes": f.stat().st_size,
                          "when": time.strftime("%Y-%m-%d %H:%M:%S",
                                                time.localtime(f.stat().st_mtime))}
                         for f in files[:50]])


@app.delete("/cycles/{name}")
async def del_cycle(name: str):
    """Borra un ensayo. Irreversible: no hay papelera."""
    safe = Path(name).name          # nunca una ruta, igual que al descargar
    path = CYCLE_DIR / safe
    if path.suffix != ".csv" or not path.is_file():
        return JSONResponse({"error": "no existe"}, status_code=404)
    # El ensayo que se está grabando ahora mismo no se toca: borrarlo con el fichero
    # abierto dejaría al grabador escribiendo en algo que ya no está en ningún sitio.
    if rec["f"] is not None and rec["path"] and rec["path"].name == safe:
        return JSONResponse({"error": "ese ensayo se está grabando ahora"}, status_code=409)
    path.unlink()
    log.info("REC   borrado %s", safe)
    return JSONResponse({"ok": True, "name": safe})


@app.get("/cycles/{name}")
async def get_cycle(name: str):
    # Sólo un nombre de fichero, nunca una ruta: sin esto, "../.." serviría cualquier
    # cosa del disco a quien abriera la página.
    safe = Path(name).name
    path = CYCLE_DIR / safe
    if path.suffix != ".csv" or not path.is_file():
        return JSONResponse({"error": "no existe"}, status_code=404)
    return FileResponse(path, media_type="text/csv", filename=safe)


@app.get("/")
async def index():
    return HTMLResponse((Path(__file__).parent / "static" / "index.html").read_text())

@app.websocket("/ws")
async def ws_endpoint(ws: WebSocket):
    await ws.accept()
    clients.add(ws)
    try:
        while True:
            text = await ws.receive_text()
            _handle_command(json.loads(text))
    except WebSocketDisconnect:
        pass
    finally:
        clients.discard(ws)

def _ack(action: str, ok: bool, detail: str):
    """Todo comando contesta. Sin esto, un comando que no llega a salir por el puerto
    —o que no lo reconoce nadie— se pierde en silencio y desde la interfaz es
    indistinguible de uno que sí ha funcionado."""
    msg_deque.append({"type": "cmd_ack", "cmd": action, "ok": bool(ok), "detail": detail})
    log.info("ACK   %-9s %-4s %s", action, "OK" if ok else "FALLO", detail)


def _handle_command(cmd: dict):
    action = cmd.get("cmd", "")
    extra = " ".join(f"{k}={v}" for k, v in cmd.items() if k != "cmd")
    log.info("CMD   %-9s %s", action, extra)

    ser = ser_ref[0]
    if not ser:
        _ack(action, False, "sin puerto serie: el Pico no está conectado")
        return

    try:
        if action == "init":
            addr = int(cmd.get("addr", 0))
            payload = bytes([CMD_INIT, addr]) if 0 < addr <= 247 else bytes([CMD_INIT])
            ser.write(build_packet(payload))
            with shared_lock:
                shared["pos_rev"] = 0.0
                shared["last_t"] = None
        elif action == "stop":
            ser.write(build_packet(bytes([CMD_STOP])))
        elif action == "move_a":
            ser.write(build_packet(bytes([CMD_MOVE_A])))
        elif action == "move_b":
            ser.write(build_packet(bytes([CMD_MOVE_B])))
        elif action == "shutdown":
            ser.write(build_packet(bytes([CMD_SHUTDOWN])))
        elif action == "home":
            ser.write(build_packet(bytes([CMD_HOME])))
        elif action == "lc_query":
            ser.write(build_packet(bytes([CMD_LC_QUERY])))
        elif action == "set_calib":
            # La calibración buena de LC1 la tiene el navegador (float, y con signo);
            # el firmware sólo guarda un int16 que no usa. Se anota aquí para que vaya
            # completa en la cabecera del CSV.
            with shared_lock:
                shared["lc1_calib"]  = float(cmd.get("calib", 0) or 0)
                shared["lc1_offset"] = float(cmd.get("offset", 0) or 0)
            _ack(action, True, "calibración de LC1 anotada")
            return
        elif action == "cycle_start":
            # modo 0 = B es el final de carrera; 1 = B es la posición indicada
            mode = 0 if int(cmd.get("to_limit", 1)) else 1
            tgt  = max(0, min(32767, int(round(float(cmd.get("target_rev", 0)) * 100))))
            spd  = max(0, min(300, int(cmd.get("speed", 10))))
            rep  = max(0, min(65535, int(cmd.get("reps", 1))))
            ser.write(build_packet(bytes([CMD_CYCLE_START, mode])
                                   + struct.pack("<hhH", tgt, spd, rep)))
        elif action == "cycle_stop":
            ser.write(build_packet(bytes([CMD_CYCLE_STOP])))
        elif action == "lc_hold":
            # park: 0 = líneas en alta impedancia, 1 = forzadas a masa
            park = 1 if int(cmd.get("park", 0)) else 0
            ser.write(build_packet(bytes([CMD_LC_HOLD, park])))
        elif action == "lc_program":
            # Las dos palabras enteras. El firmware sanea lo intocable (I2C/SPI, bits
            # reservados, polaridades de temperatura) antes de escribir nada.
            bcfg = int(cmd.get("bcfg", 0)) & 0xFFFF
            cfg1 = int(cmd.get("cfg1", 0)) & 0xFFFF
            ser.write(build_packet(bytes([CMD_LC_PROGRAM]) + struct.pack("<HH", bcfg, cfg1)))
        elif action == "reset_pos":
            with shared_lock:
                shared["pos_rev"] = 0.0
                shared["last_t"] = None
        elif action == "set_param":
            pid = int(cmd.get("param", 0))
            val = int(cmd.get("value", 0))
            if pid == PARAM_FORCE_CALIB:
                with shared_lock:
                    shared["force_calib"] = val
            ser.write(build_packet(bytes([CMD_SET_PARAM, pid]) + struct.pack("<h", val)))
        else:
            # Sin este caso, un nombre mal escrito en la interfaz no hacía nada y no
            # se notaba: el botón parecía roto sin decir por qué.
            _ack(action, False, f"acción desconocida: {action!r}")
            return
    except (serial.SerialException, OSError) as e:
        # Puerto caído (p.ej. reflasheo/replug): soltar el handle; el hilo serie reconecta.
        print(f"# Serial write error: {e}  (marcando desconectado)")
        ser_ref[0] = None
        try: ser.close()
        except Exception: pass
        _ack(action, False, f"error de puerto: {e}")
        return
    except Exception as e:
        _ack(action, False, f"{type(e).__name__}: {e}")
        return
    _ack(action, True, "enviado")

if __name__ == "__main__":
    uvicorn.run(app, host="0.0.0.0", port=8080)
