javilxpez/TFG_Javi_lopez/(commit log)

2026-03-04 Create loadcell_torquemode.py
    V1.0
    Control por celula de carga+ torque mode.
2026-03-04 Create speedtorque_mode.ino
    Primera version de arduino.
    Speed mode+torque mode funcional.
    A falta de implementar el lazo de control con la celula de carga.
2026-03-05 Create monitor.py
    Codigo con interfaz funcional:
    Implementada la comunicacion con el servo y celula de carga.
    Distintos modos de uso modo speed y modo torque.
    VERSION 1.0 pendiente a realizar cambios de optimización
2026-03-05 Create firmware.ino
    Código imolementado en el módulo que recibe el valor de la celula de carga
2026-03-10 code v1.0
    todo el codigo actualizado
2026-03-10 Replaced magic numbers by defines on modbusvars
    [firmware.ino]
2026-03-10 Addes braking resistor parameters C10-13
2026-03-10 non functional print resolved
    [monitor.py]
2026-03-10 added controlling parameters stiffnes level and torque+speed limits in torque mode
    [firmware.ino]
2026-03-13 PCB adapter
    Pcb design kicad
    [tfg_adaptador.kicad_pcb, tfg_adaptador.kicad_sch]
2026-03-17 ACTUALIZACION PCB
    [tfg_adaptador.kicad_pcb, tfg_adaptador.kicad_sch]
2026-06-20 V2.0 TEST RASPBERRY ADDED
2026-06-30 se añade dualcore codigo correctoa falta de maqueta final
    [firmwarerasp.ino]
2026-09-06 added cicle+ensayos
    [20260906-125258_ciclo.csv]
2026-09-14 addes somethings
    [20260906-125258_ciclo.csv, 20260914-183121_ciclo.csv, 20260914-184729_ciclo.csv, 20260914-190535_ciclo.csv, 20260914-190826_ciclo.csv, 20260914-194105_ciclo.csv, 20260914-194640_ciclo.csv, 20260914-194648_ciclo.csv]
2026-10-07 final changes
    [20261007-185831_ciclo.csv, 20261007-193503_ciclo.csv, 20261007-201817_ciclo.csv, 20261007-202101_ciclo.csv, 20261007-202355_ciclo.csv, 20261007-203734_ciclo.csv, 20261007-203807_ciclo.csv, 20261007-203955_ciclo.csv]
2026-10-27 Análisis del tambor sobre la campaña del 14-10
2026-10-27 Ensayos del 27-10: 30 rpm, 10 rpm y 10 repeticiones a 10 rpm
